adrian-dumitrescu/IoT-CAN-Battery-Monitoring/README.md

# IoT-CAN-Battery-Monitoring

Information about the device is presented in the pCloud_Documentation.pdf file.
- [x] Arduino IDE
- [x] Based on ESP8266
- [x] IoT monitoring with Thingsboard Dashboard
- [x] CAN-BUS

## License
[MIT](https://choosealicense.com/licenses/mit/)
