adrian-dumitrescu/IoT-CAN-Battery-Monitoring/pCloud_PCB/Assembly/BOM.xlsx

QTY | Parts | Description | Value | Footprint (in) | Mounting Style | Manufacturer Part Number | Manufacturer | Supplyer | Supplyer Link | Price/Unit | Price/Total | TOTAL
 | Resistors |  |  |  |  |  |  |  |  |  | 0.000 €
1 | R2 | Thick Film Resistors - SMD 1/16watt 124Kohms 1% | 124K | 0402 | SMD | CRCW0402124KFKED | Vishay / Dale | Mouser | Link1 (https://ro.mouser.com/ProductDetail/Vishay-Dale/CRCW0402124KFKED?qs=rlE3Te1NifzljNPs8nbYHA%3D%3D) | 0.090 € | 0.09 € | 49.87 €
1 | R8 | Thick Film Resistors - SMD 1/16watt 383Kohms 1% | 383K | 0402 | SMD | CRCW0402383KFKED | Vishay / Dale | Mouser | Link2 (https://ro.mouser.com/ProductDetail/Vishay-Dale/CRCW0402383KFKED?qs=iv%252Be0Bc5VY1yPDNCGroJqg%3D%3D) | 0.090 € | 0.09 €
1 | R12 | Thick Film Resistors - SMD 1/16watt 102Kohms 1% 100ppm | 102K | 0402 | SMD | CRCW0402102KFKED | Vishay / Dale | Mouser | Link3 (https://ro.mouser.com/ProductDetail/Vishay-Dale/CRCW0402102KFKED?qs=rlE3Te1NifwphdA8fQQlsA%3D%3D) | 0.090 € | 0.09 €
1 | R10 | Thick Film Resistors - SMD 1/16watt 100Kohms 1% | 100K | 0402 | SMD | CRCW0402100KFKED | Vishay / Dale | Mouser | Link4 (https://ro.mouser.com/ProductDetail/Vishay-Dale/CRCW0402100KFKED?qs=OlqPY1CiralZGKRwQ4Glcg%3D%3D) | 0.090 € | 0.09 €
2 | R13, R14 | RES SMD 1/10Watt 100ohms 1% | 100 | 0603 | SMD | CRCW0603100RFKEAC | Vishay / Dale | Mouser | Link5 (https://ro.mouser.com/ProductDetail/Vishay-Dale/CRCW0603100RFKEAC) | 0.090 € | 0.18 €
2 | R16, R17 | RES 0.25watt 10Kohms 1% 100ppm | 10K | 0603 | SMD | RCS060310K0FKEA | Vishay / Dale | Mouser | Link6 (https://ro.mouser.com/ProductDetail/Vishay-Dale/RCS060310K0FKEA) | 0.140 € | 0.28 €
8 | R5, R1, R3, R4, R7, R9, R20, R23 | Thick Film Resistors - SMD 10K OHM 1% 1/4W TC100 | 10K | 0603 | SMD | CMP0603AFX-1002ELF | Bourns | Mouser | Link7 (https://ro.mouser.com/ProductDetail/Bourns/CMP0603AFX-1002ELF?qs=TiOZkKH1s2Q14lKL9rbzLg%3D%3D) | 0.090 € | 0.72 €
1 | R25 | Thick Film Resistors - SMD 120 Ohm | 120 | 0603 | SMD | RC0603JR-7W120RL | Yageo | Mouser | Link8 (https://ro.mouser.com/ProductDetail/Yageo/RC0603JR-7W120RL) | 0.090 € | 0.09 €
1 | R21 | Thick Film Resistors - SMD 1/10Watt 22ohms 5% Commercial Use | 22 | 0603 | SMD | CRCW060322R0JNEAC | Vishay / Dale | Mouser | Link9 (https://ro.mouser.com/ProductDetail/Vishay-Dale/CRCW060322R0JNEAC?qs=E3Y5ESvWgWMu6NbfEetfrA%3D%3D) | 0.090 € | 0.09 €
2 | R11, R22 | Thin Film Resistors - SMD 1K ohm 1% 1/10W | 1 K | 0603 | SMD | RT0603FRE071KL | Yageo | Mouser | Link10 (https://ro.mouser.com/ProductDetail/Yageo/RT0603FRE071KL?qs=8cPjvKtxWv68ZVEzoi6JxQ%3D%3D) | 0.090 € | 0.18 €
2 | R15, R6 | RES 4.7Kohms 1% | 4.7K | 0603 | SMD | ERJ-3EKF4701V | Panasonic | Mouser | Link11 (https://ro.mouser.com/ProductDetail/Panasonic/ERJ-3EKF4701V) | 0.100 € | 0.20 €
1 | R26 | Thick Film Resistors - SMD 1/8Watt 470ohms 1% Commercial Use | 470 | 0805 | SMD | CRCW0805470RFKEAC | Vishay / Dale | Mouser | Link12 (https://ro.mouser.com/ProductDetail/Vishay-Dale/CRCW0805470RFKEAC?qs=E3Y5ESvWgWPsF5leBpDSrQ%3D%3D) | 0.090 € | 0.09 €
 | Capacitors |  |  |  |  |  |  |  |  |  | 0.000 €
1 | C12 | Multilayer Ceramic Capacitors MLCC - SMD/SMT 0402 6.2pF 50volts C0G +/-0.25pF | 6.2 pF | 0402 | SMD | GRM1555C1H6R2CA01D | Murata Electronics | Mouser | link13 (https://ro.mouser.com/ProductDetail/Murata-Electronics/GRM1555C1H6R2CA01D?qs=e%252BE4OD6MgMdxw4b5lMPkpQ%3D%3D) | 0.090 € | 0.09 €
1 | C15 | Multilayer Ceramic Capacitors MLCC - SMD/SMT 0.056uF 16Volts 10% | 56 nF | 0402 | SMD | GRM155R71C563KA88D | Murata Electronics | Mouser | Link14 (https://ro.mouser.com/ProductDetail/Murata-Electronics/GCM155R71C333KA37D?qs=QDXoN8f0aYKQeBiDvEx%2FuA%3D%3D) | 0.085 € | 0.09 €
8 | C16, C17, C18, C21, C22, C23, C26, C27 | Multilayer Ceramic Capacitors MLCC - SMD/SMT 100Vdc 10uF 10% 1210/2502 | 10 uF | 1210 | SMD | GRM32EC72A106KE05L | Murata Electronics | Mouser | Link15 | 1.170 € | 9.36 €
2 | C1, C10 | CAP 0.1uF 25V 20% 0603 | 0.1 uF | 0603 | SMD | CC0603ZRY5V8BB104 | Yageo | Mouser | Link16 (https://ro.mouser.com/ProductDetail/Yageo/CC0603ZRY5V8BB104) | 0.090 € | 0.18 €
4 | C13, C6, C8, C9 | CAP 10UF 25V 10% 0805 | 10 uF | 0805 | SMD | GRM21BR61E106KA73K | Murata Electronics | Mouser | Link17 (https://ro.mouser.com/ProductDetail/Murata-Electronics/GRM21BR61E106KA73K) | 0.230 € | 0.92 €
2 | C3, C4 | CAP 560pF +-5% 50V | 560 pF | 0603 | SMD | 0603N561J500CT | Walsin | Mouser | Link18 (https://ro.mouser.com/ProductDetail/Walsin/0603N561J500CT) | 0.110 € | 0.22 €
2 | C19, C20 | Multilayer Ceramic Capacitors MLCC - SMD/SMT WCAP-CSGP 22pF 0603 5% 50V MLCC | 22 pF | 0603 | SMD | 885012006053 | Wurth Elektronik | Mouser | Link19 (https://ro.mouser.com/ProductDetail/Wurth-Elektronik/885012006053?qs=0KOYDY2FL28j0s08hcyKIA%3D%3D) | 0.090 € | 0.18 €
1 | C7 | CAP 1.0uF 25V X5R 10% | 1 uF | 0603 | SMD | CC0603KRX5R8BB105 | Yageo | Mouser | Link20 (https://ro.mouser.com/ProductDetail/Yageo/CC0603KRX5R8BB105) | 0.090 € | 0.09 €
 | Other |  |  |  |  |  |  |  |  |  | 0.000 €
1 | X4 | USB Connectors 5P Quick Connect MicroUSB TypeAB Rcpt | - | - | SMD | 10104111-0001LF | Amphenol FCI | Mouser | Link21 (https://ro.mouser.com/ProductDetail/Amphenol-FCI/10104111-0001LF) | 0.600 € | 0.60 €
1 | IC2 | Supervisory Circuits 2.63V, 50ms MPU Reset Circuit | - | SOT-23-3 | SMD | APX803S05-26SA-7 or APX803S05-29SA-7 | Diodes Incorporated | Mouser | Link22 (https://ro.mouser.com/ProductDetail/Diodes-Incorporated/APX803S05-26SA-7?qs=AQlKX63v8RvXe1ZyLv0H1A%3D%3D) | 0.310 € | 0.31 €
1 | D4 | Schottky Diodes & Rectifiers 2.0A 70V | - | SMB | SMD | B270-13-F | Diodes Incorporated | Mouser | Link23 (https://ro.mouser.com/ProductDetail/Diodes-Incorporated/B270-13-F) | 0.340 € | 0.34 €
1 | Q4 | MOSFET SOT-23 N-CH LOGIC | - | SOT-23-3 | SMD | BSS138 | ON Semiconductor / Fairchild | Mouser | Link24 (https://ro.mouser.com/ProductDetail/ON-Semiconductor-Fairchild/BSS138?qs=HK%252BeIG1iaahCeqBvjB4arg%3D%3D) | 0.220 € | 0.22 €
1 | IC1 | I/O Controller Interface IC USB to UART Bridge QFN24 | - | QFN-24 | SMD | CP2104-F03-GMR | Silicon Labs | Mouser | Link25 (https://ro.mouser.com/ProductDetail/Silicon-Labs/CP2104-F03-GMR?qs=1CB38rTTsYrRJKVkczeRzA%3D%3D) | 1.400 € | 1.40 €
1 | IC3 | ESP8266 WiFi 802.11b/g/n 160Mbits | - | - | SMD | ESP-07S | RF Solutions | Mouser | Link26 (https://ro.mouser.com/ProductDetail/RF-Solutions/ESP-07S) | 8.540 € | 8.54 €
2 | S2, S5 | Tactile Switches SPST NO-G LEAD 200g | - | - | SMD | KSS221GLFS | C&K | Mouser | Link27 (https://ro.mouser.com/ProductDetail/CK/KSS221GLFS) | 0.640 € | 1.28 €
1 | D5 | Schottky Diodes & Rectifiers 1A 20V | - | SOD-123FL | SMD | MBR120VLSFT1G | ON Semiconductor | Mouser | Link28 (https://ro.mouser.com/ProductDetail/ON-Semiconductor/MBR120VLSFT1G) | 0.370 € | 0.37 €
1 | U4 | CAN Interface IC W/ SPI Interface |  | SOIC-18 | SMD | MCP2515-I/SO | Microchip Technology | Mouser | Link29 (https://ro.mouser.com/ProductDetail/Microchip-Technology/MCP2515-I-SO?qs=KwArPi4cUogGDbGnphOvtQ%3D%3D) | 1.540 € | 1.54 €
3 | Q1, Q2, Q6 | Bipolar Transistors - BJT SS SOT23 GP XSTR NPN 30V | - | SOT-23-3 | SMD | MMBT2222LT1G | ON Semiconductor | Mouser | Link30 (https://ro.mouser.com/ProductDetail/ON-Semiconductor/MMBT2222LT1G?qs=HVbQlW5zcXXDmyyswaLspw%3D%3D) | 0.110 € | 0.33 €
1 | D8 | TVS Diodes CAN BUS ESD PROTECT | - | - | SMD | PESD1CAN,215 | Nexperia | Mouser | Link31 (https://ro.mouser.com/ProductDetail/Nexperia/PESD1CAN215?qs=sGAEpiMZZMvKM5ialpXrmt7n0iEMMoO8) | 0.410 € | 0.41 €
1 | IC6 | CAN Interface IC STANDBY MODE |  | SOIC-8 | SMD | SN65HVD230DR | Texas Instruments | Mouser | Link32 (https://ro.mouser.com/ProductDetail/Texas-Instruments/SN65HVD230DR?qs=QViXGNcIEAtifeQR3pYVUQ%3D%3D) | 1.850 € | 1.85 €
1 | U2 | LDO Voltage Regulators 500mA | - | SOT-23-5 | SMD | SPX3819M5-L-3-3/TR | MaxLinear | Mouser | Link33 (https://ro.mouser.com/ProductDetail/MaxLinear/SPX3819M5-L-3-3-TR) | 0.630 € | 0.63 €
1 | S1 | Slide Switches slide switch with location lug | - | - | SMD | SSAJ110100 | Alps Alpine | Mouser | Link34 (https://ro.mouser.com/ProductDetail/Alps-Alpine/SSAJ110100) | 1.510 € | 1.51 €
1 | LED4 | SK6812 LEDs | - | 5050 | SMD | 2760 | Adafruit | Mouser | Link35 (https://ro.mouser.com/ProductDetail/Adafruit/2760?qs=F12%252BZJI6bgoI7KDe7TbBLw%3D%3D) | 0.504 € | 0.50 €
1 | D1 | DIODE-SCHOTTKYSOD-123 | - | SOD-123FL | SMD | MBR120ESFT3G | ON Semiconductor | Mouser | Link36 (https://ro.mouser.com/ProductDetail/ON-Semiconductor/MBR120ESFT3G) | 0.320 € | 0.32 €
1 | L1 | CLF6045T-151M-D | 150uH | - | SMD | CLF6045T-151M-D or CLF6045T-101M-D | TDK | Mouser | Link38 (https://ro.mouser.com/ProductDetail/TDK/CLF6045T-151M-D) | 1.120 € | 1.12 €
1 | IC4 | Switching Voltage Regulators | - | VSON-10 | SMD | LM5166DRCR | Texas Instruments | Mouser | Link39 (https://ro.mouser.com/ProductDetail/Texas-Instruments/LM5166DRCR?qs=34RfhUjJmKfBnYp2E2XqEQ%3D%3D) | 2.870 € | 2.87 €
1 | Q3 | Crystal SMD 16MHz | 16Mhz | - | SMD | COM-00094 | SparkFun | Mouser | Link40 (https://ro.mouser.com/ProductDetail/SparkFun/COM-00094) | 1.350 € | 1.35 €
EXTERNAL COMPONENTS (NOT TO BE MOUNTED / BOUGHT):
QTY | Parts | Description | Value | Footprint (in) | Mounting Style | Manufacturer Part Number | Manufacturer | Supplyer | Supplyer Link | Price/Unit | Price/Total | TOTAL
1 | DISP1 | 1.14 inch IPS HD TFT LCD display with 135x240 dots | - | - | SMD | ER-TFT1.14-1 | EastRising | buydisplay | Link41 (https://www.buydisplay.com/1-14-inch-tft-lcd-display-ips-panel-screen-135x240-for-smart-watch) | 2.60 € | 2.60 €
1 | CON | USB Connectors MICRO B PLUG ASBY VERT PCB | - | - | TH | ZX20-B-5S-UNIT(30) | Hirose Connector | Mouser | Link42 (https://ro.mouser.com/ProductDetail/Hirose-Connector/ZX20-B-5S-UNIT30) | 0.74 € | 0.74 €
1 | CON-Metal | USB Connectors MICRO B PLUG SHIELD FOR ZX20 VERT TH | - | - | TH | ZX20-B-SLDC | Hirose Connector | Mouser | Link43 (https://ro.mouser.com/ProductDetail/Hirose-Connector/ZX20-B-SLDC) | 0.22 € | 0.22 €
1 | Antenna | 2.4G 5.8G dual band FPC Antenna 31*5.5 cm | - | - | Snap In |  | - | Alibaba |  | 0.40 € | 0.40 €
1 | Panel CON | USB Connectors RUGGED MICRO AB VERTICAL | - | - | Panel | MUSBK55230 | Amphenol Commercial Products | Mouser | Link44 (https://ro.mouser.com/ProductDetail/Amphenol-Commercial-Products/MUSBK55230?qs=z4I1WACWgPQfLC8Dgw9I8w%3D%3D) | 7.1 | 7.10 €
