adrian-dumitrescu/IoT-CAN-Battery-Monitoring/pCloud_PCB/Assembly/3D_Render/pCloud_ESP926_BOT.png

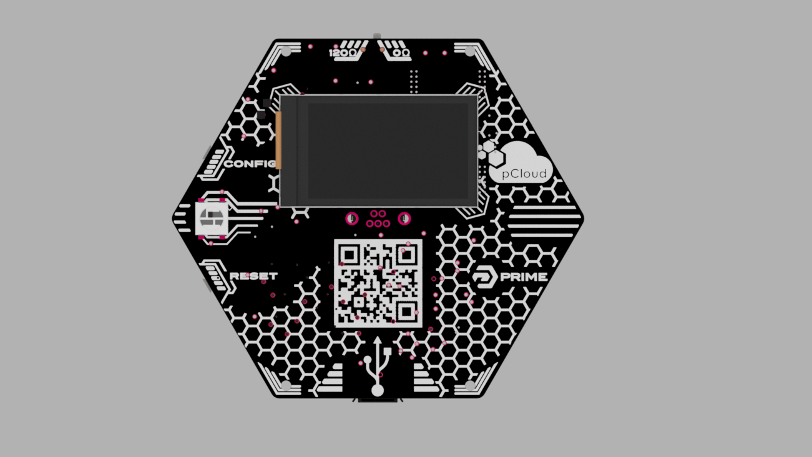
pCloud_PCB/Assembly/3D_Render/pCloud_ESP926_BOT.png
