adrian-dumitrescu/IoT-CAN-Battery-Monitoring/pCloud_Documentation.pdf

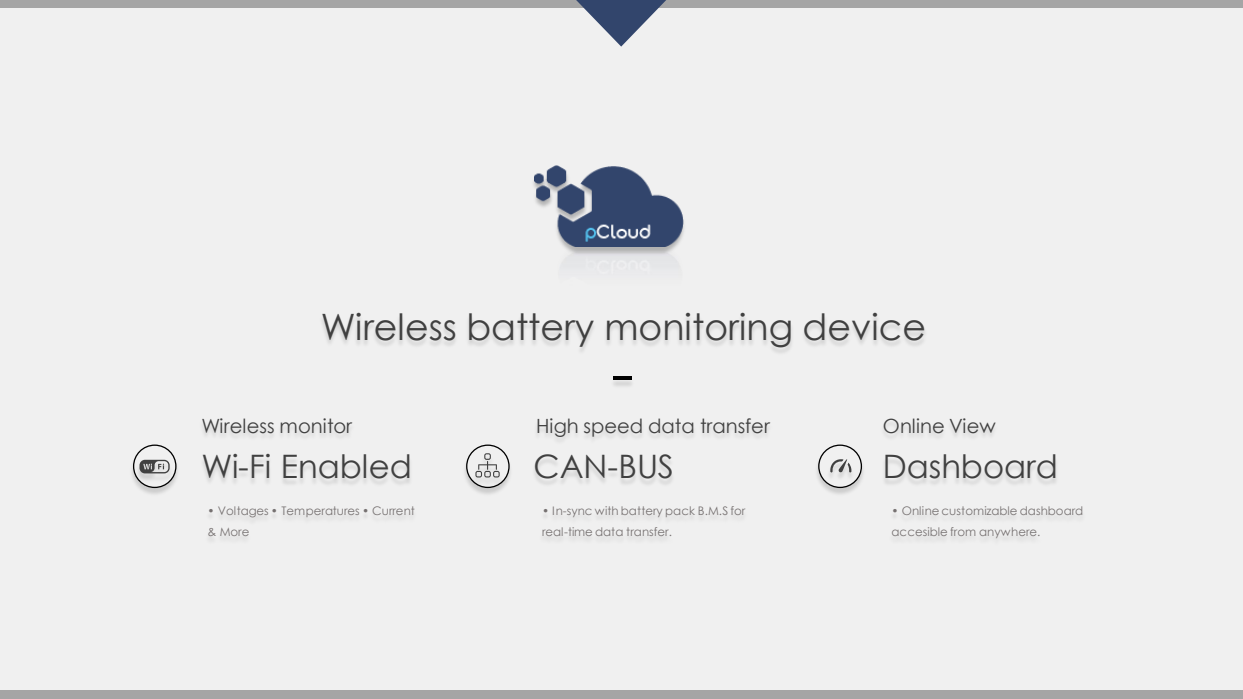
[picture p5: page 1]
Online View Dashboard

Wireless battery monitoring device

Wireless monitor
Wi-Fi Enabled

High speed data transfer
CAN-BUS

• Voltages • Temperatures • Current
& More

• In-sync with battery pack B.M.S for
real-time data transfer.

• Online customizable dashboard

accesible from anywhere.

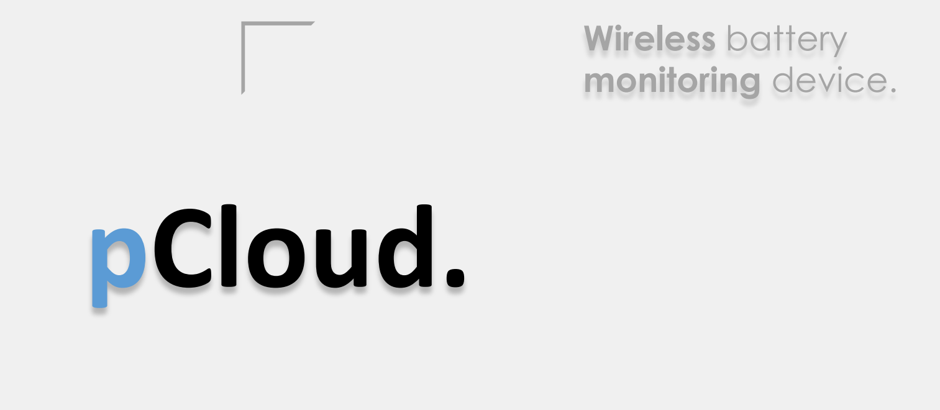
[picture p6: figure]
pCloud.; Wireless battery monitoring device.

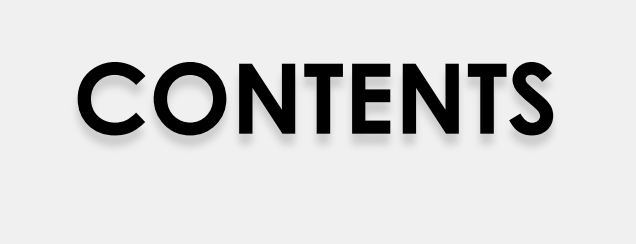
[picture p7: figure]
CONTENTS

# 03 Design

# 04 Dashboard

## 01 Brief introduction into what pCloud is and what it wants to

## 03 Sneak peek of the pCloud. Preview our out of the box solution

## 04 Online dashboard that provides 24/7 instant data, charts of

recent history, and diagnostic information.

# 02 Architecture

## 02 The data transportation architecture is designed to distribute

workload across multiple nodes without a single point of failure.

01. INTRODUCTION.

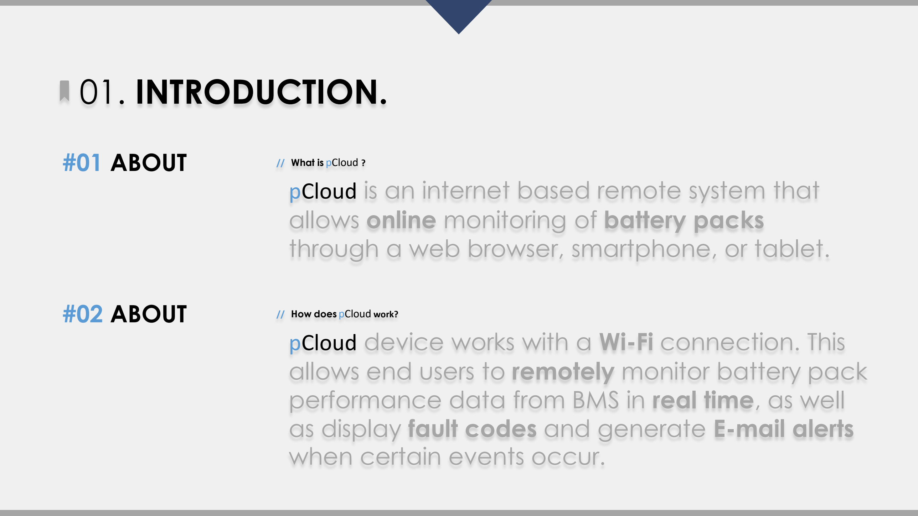
[picture p8: page 4]

# pCloud is an internet based remote system that allows online monitoring of battery packs

through a web browser, smartphone, or tablet.

#01 ABOUT | // What is pCloud ?

# pCloud device works with a Wi-Fi connection. This allows end users to remotely monitor battery pack performance data from BMS in real time, as well as display fault codes and generate E-mail alerts

when certain events occur.

#02 ABOUT | // How does pCloud work?

02. ARCHITECTURE.

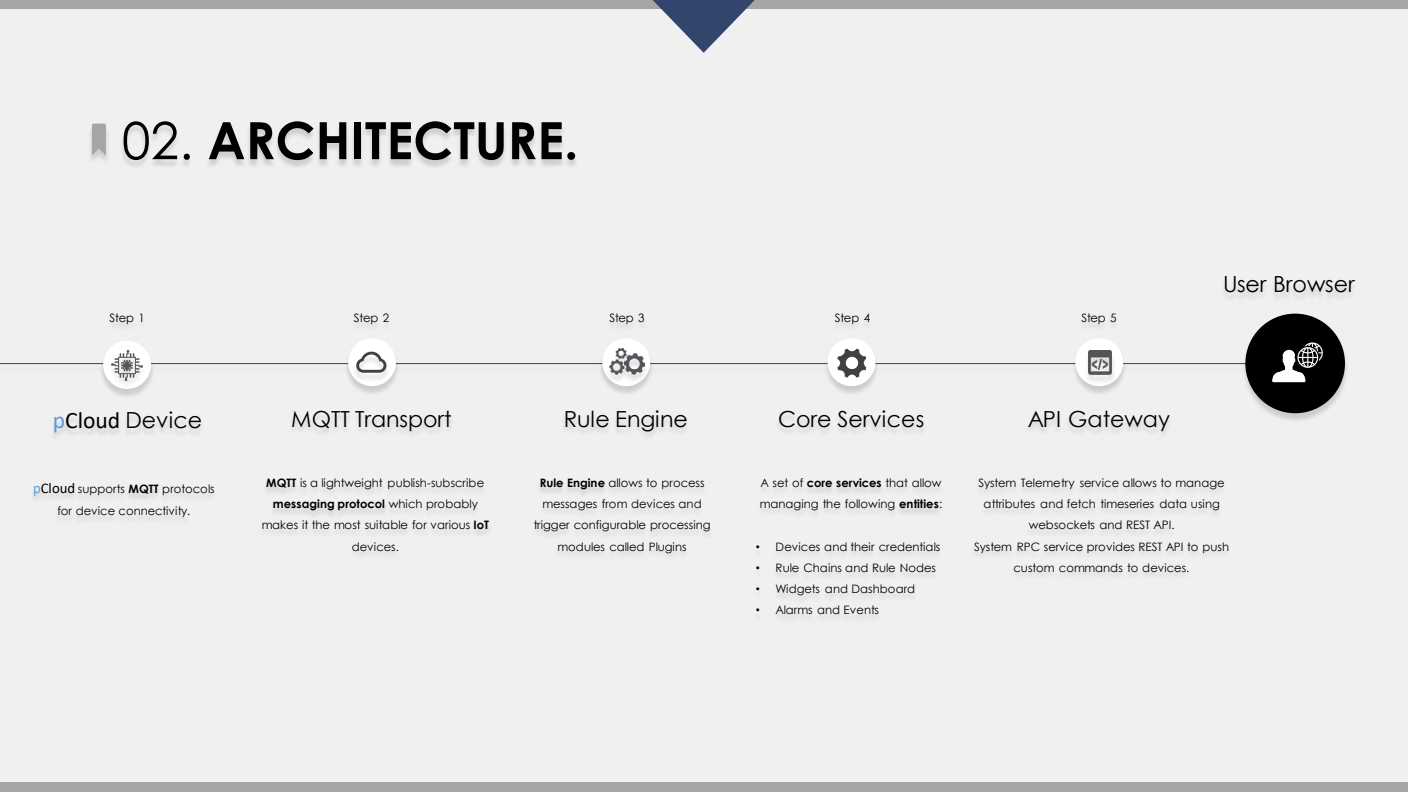
[picture p9: page 5]
pCloud Device; MQTT Transport; devices.; Rule Engine; Core Services; User Browser; API Gateway; Step 1; Step 2; Step 3; Step 4; Step 5

pCloud supports MQTT protocols

MQTT is a lightweight publish-subscribe

Rule Engine allows to process

A set of core services that allow

System Telemetry service allows to manage

for device connectivity.

messaging protocol which probably

messages from devices and

managing the following entities:

attributes and fetch timeseries data using

makes it the most suitable for various IoT

trigger configurable processing

websockets and REST API.

modules called Plugins

• Devices and their credentials

System RPC service provides REST API to push

• Rule Chains and Rule Nodes

custom commands to devices.

• Widgets and Dashboard

• Alarms and Events

Wi

## -Fi Enabled

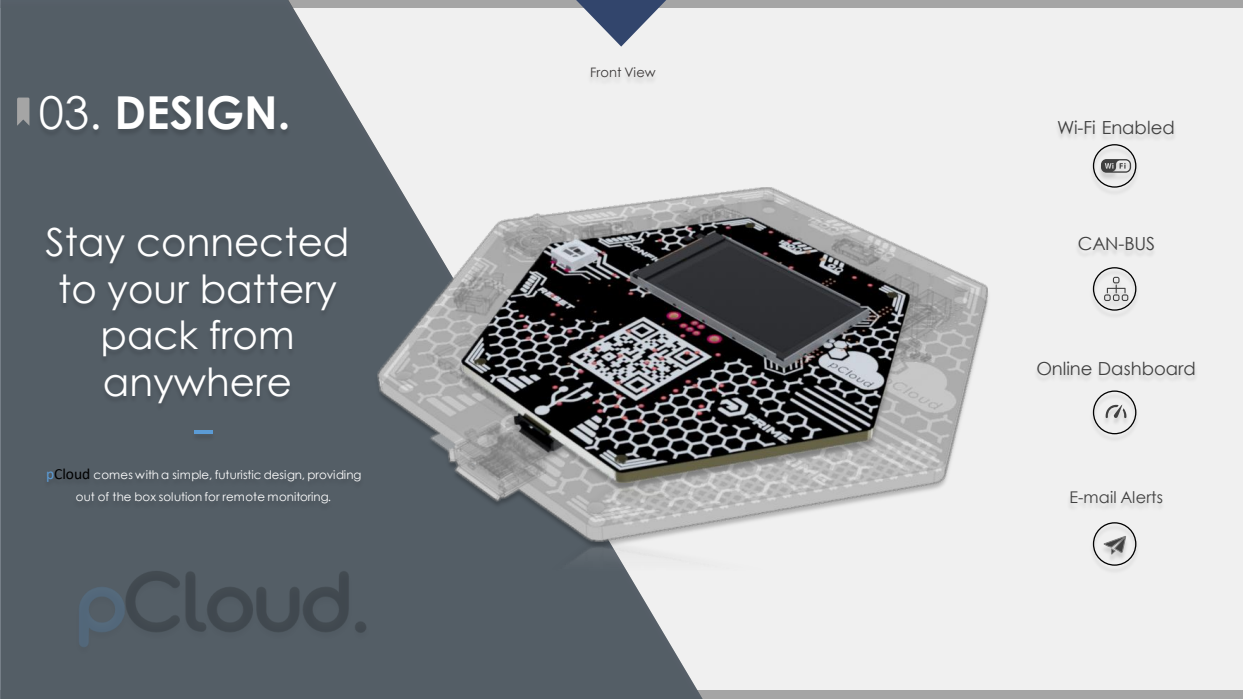
[picture p10: page 6]
CAN; -BUS; Online Dashboard; -mail Alerts; 3. DESIGN; Front View

Stay connected
to your battery
pack from
anywhere

pCloud comes with a simple, futuristic design, providing

out of the box solution for remote monitoring

# Wide viewing angle Display

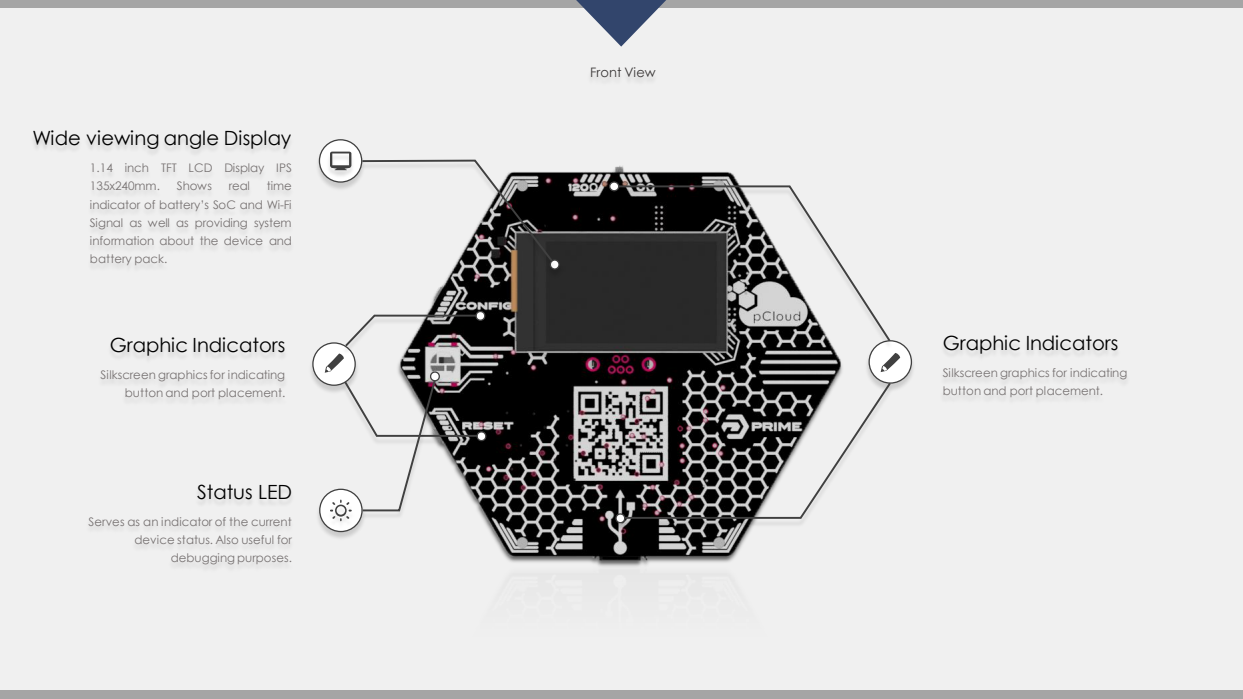
[picture p11: page 7]
debugging purposes.; Status LED; Shows; real; time; Graphic Indicators; Front View

1.14 inch TFT LCD Display IPS
indicator of battery’s SoC and Wi-Fi
Signal as well as providing system
information about the device and
battery pack.

Silkscreen graphics for indicating
button and port placement.

Serves as an indicator of the current

device status. Also useful for

## ESP8266

## μController

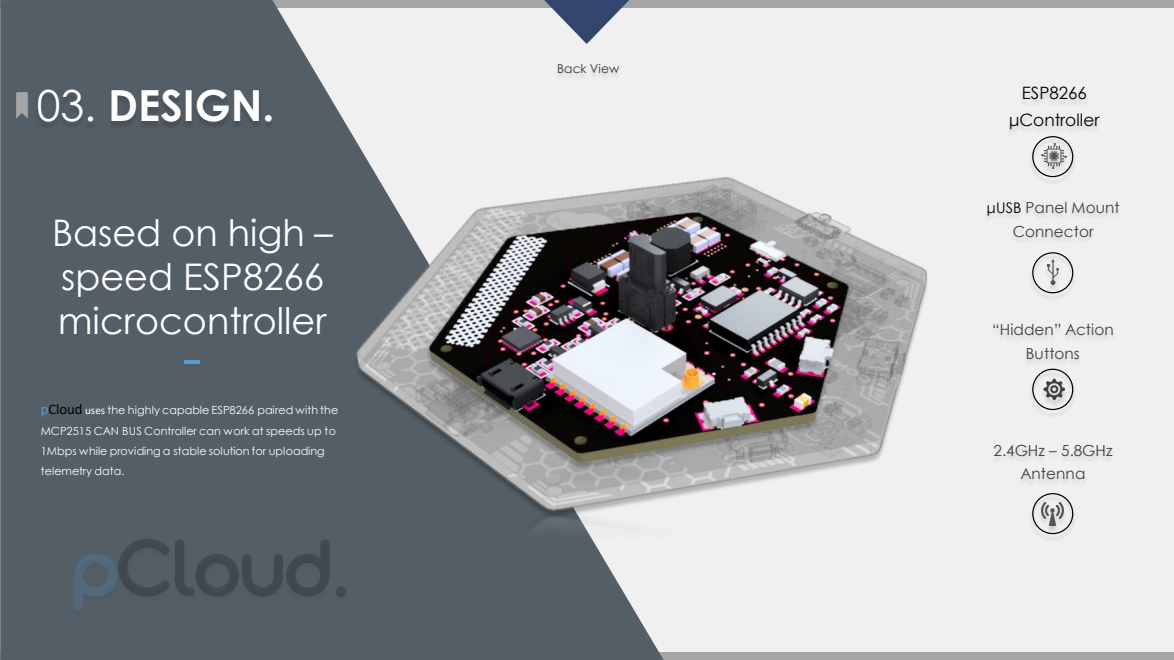
[picture p12: page 8]
telemetry data; “Hidden” Action; Buttons; 2.4GHz; – 5.8GHz; Antenna; Back View; 3. DESIGN

μUSB Panel Mount
Connector

Based on high
speed ESP8266
microcontroller

pCloud usesthe highly capable ESP8266 paired with the

MCP2515 CAN BUS Controller can work at speeds up to
1Mbps while providing a stable solution for uploading

# CAN-BUS Resistor Switch

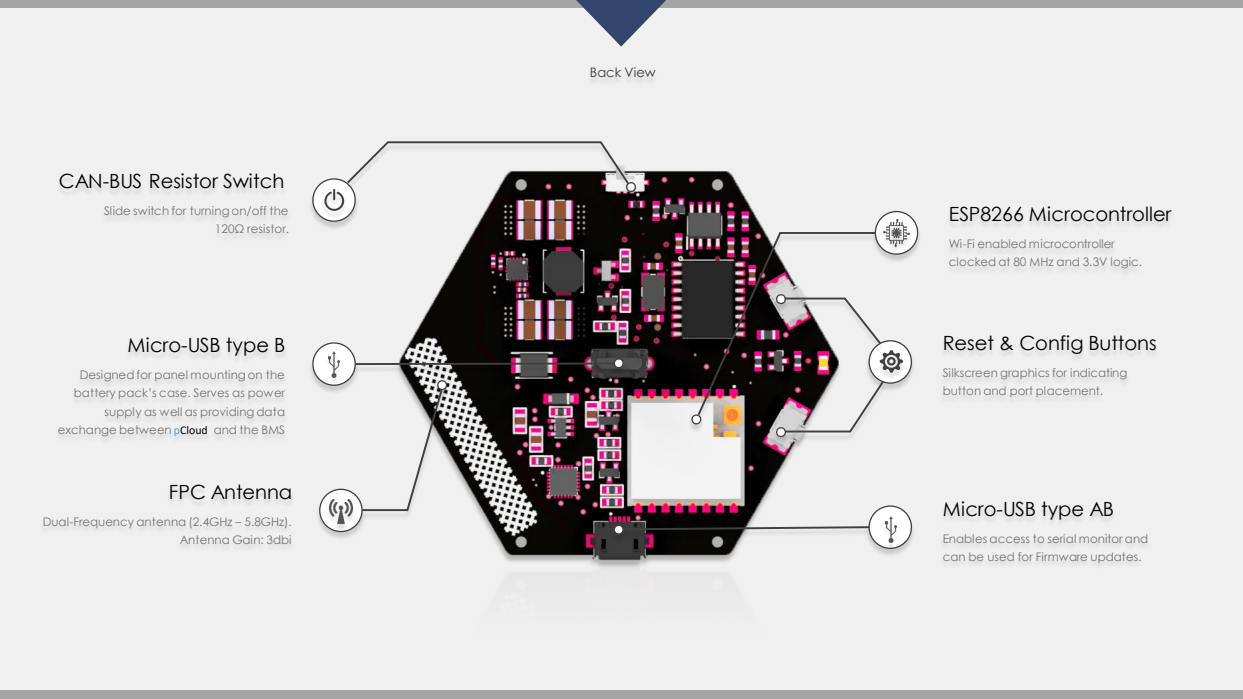
[picture p13: page 9]
Antenna Gain: 3dbi; FPC Antenna; 120Ω resistor.; Back View

ESP8266 Microcontroller Slide switch for turning on/off the

Wi-Fi enabled microcontroller
clocked at 80 MHz and 3.3V logic.

Reset & Config Buttons

Micro-USB type B

Designed for panel mounting on the
battery pack’s case. Serves as power
supply as well as providing data

Silkscreen graphics for indicating
button and port placement.

exchange between pCloud and the BMS

Micro-USB type AB

Dual-Frequency antenna (2.4GHz – 5.8GHz).

Enables access to serial monitor and
can be used for Firmware updates.

# Wide Angle Display Slide Switch

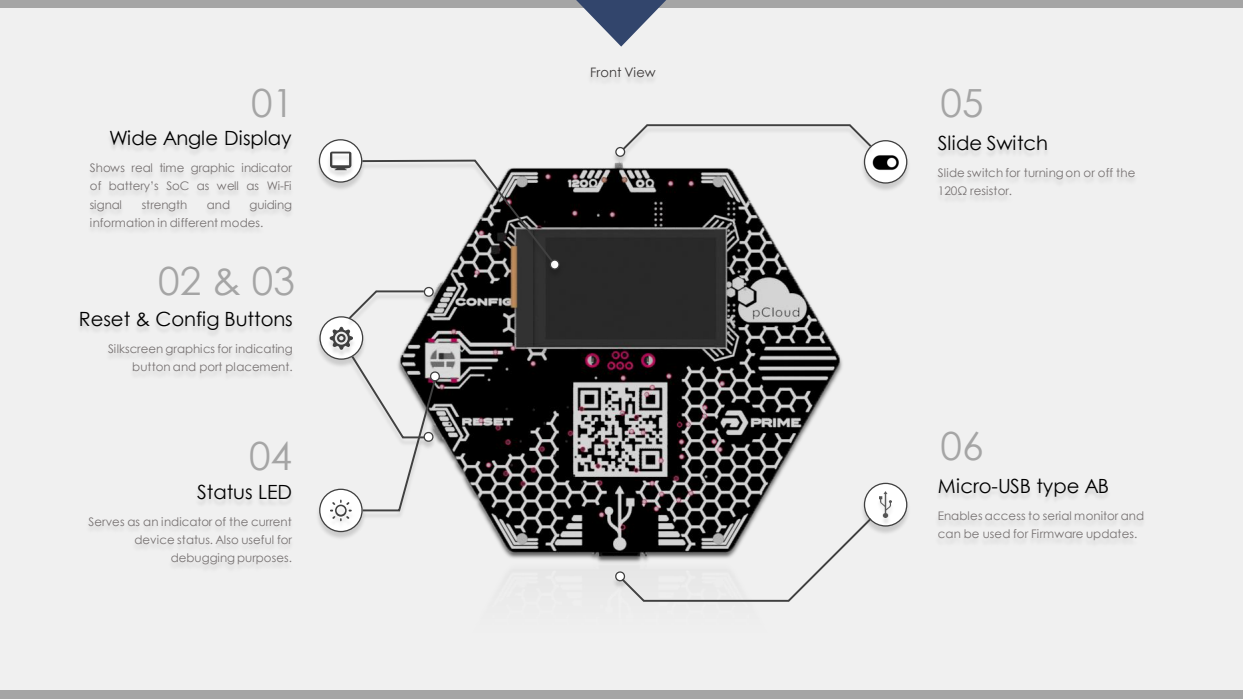
[picture p14: page 10]
debugging purposes.; Status LED; signal; strength; and; guiding; Front View; Micro

Shows real time graphic indicator
of battery’s SoC as well as Wi
information in different modes

Slide switch for turning on or off the
120Ω resistor.

Reset & Config Buttons

Silkscreen graphics for indicating
button and port placement.

-USB type AB

Enables access to serial monitor and
can be used for Firmware updates.

Serves as an indicator of the current

device status. Also useful for

01

## Signal Strength

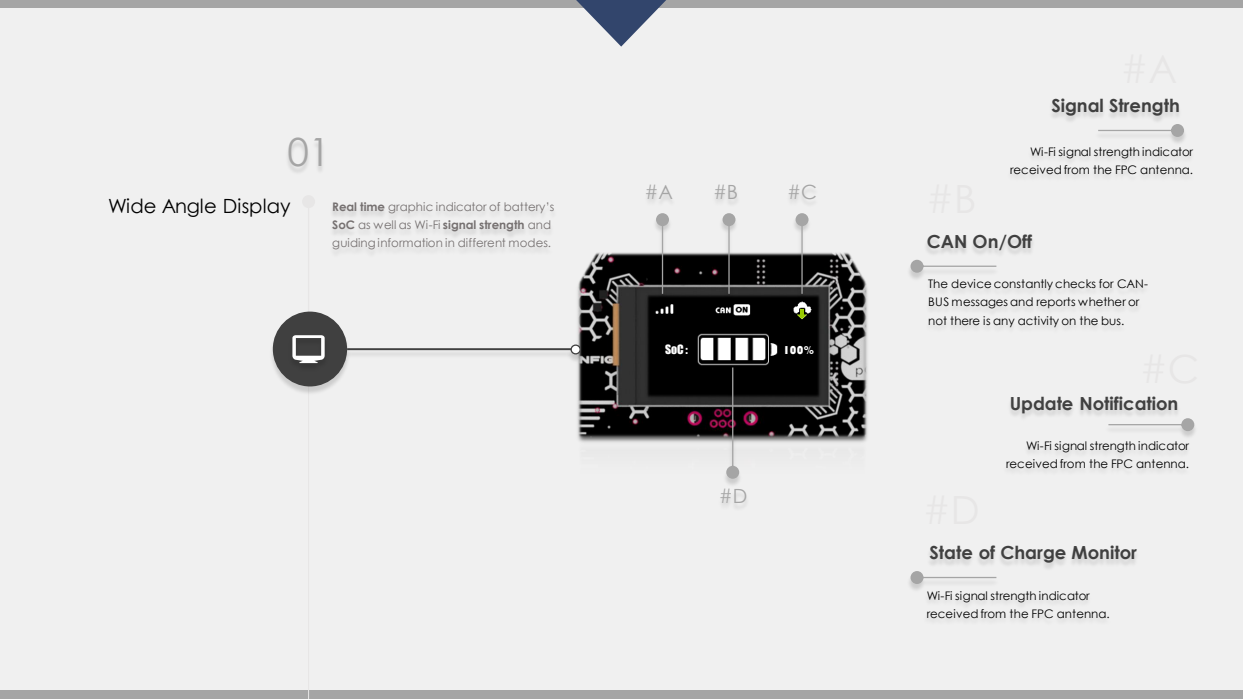
[picture p15: page 11]
SoC :; Update Notification

Wi-Fi signal strength indicator
received from the FPC antenna.

Wide Angle Display

Real time graphic indicator of battery’s
SoC as well as Wi-Fi signal strength and
guiding information in different modes.

CAN On/Off

The device constantly checks for CAN-
BUS messages and reports whether or
not there is any activity on the bus.

State of Charge Monitor

Provides two distinct functionalities:
#A. Config Portal – Hold for 5 seconds to go into Config Mode #B. Firmware Update – Double tap on the side button to perform a firmware update if there is one available.

Single press on the reset button will give a quick reset to the device.

# Reset Side Button

02

03

# Config Side Button

- Once you enter Config Mode, the device will become an Access Point.
- Connect to the Access Point using either your mobile device or PC and you will be redirected to a private Web Page.
- If you are not redirected after a few seconds, open a browser and type in the following IP: http://192.168.4.1/
- On the Web Page you will be able to insert:
- SSID : The name of the Wi-Fi that is within range of the device. This will provide internet connection to upload telemetry data.
- Password : Wi-Fi network security key.
- Server IP : Provided with the device.
- Private Token : provided with the device. Please do not share with anyone your private token.
- After inserting all information click on SAVE and wait a few seconds for your device to finish the configuration.
- The Web Page also provides useful information about the device and a help menu.

## Config Portal

#A

- Performs over the air Firmware Update if there is a new version available

## Firmware Update

#B

Serves as an indicator of the current device status. The LED will display certain colors depending on it’s current state:

#A. Constant RED

#B. Constant GREEN

#C. Color Cycle.

# 04 Status LED

## Constant RED

#A

The RED color indicates that the device lost connectivity and is trying to reconnect to the Wi-Fi. If this problem persists the signal strength might not be strong enough to maintain good connection.

The device is into Config Mode and is waiting for you to finish the configuration process.

## Constant GREEN

#B

## Color Cycle

#C

While the device is monitoring the Battery Pack, it the LED will smoothly cycle through all colors.

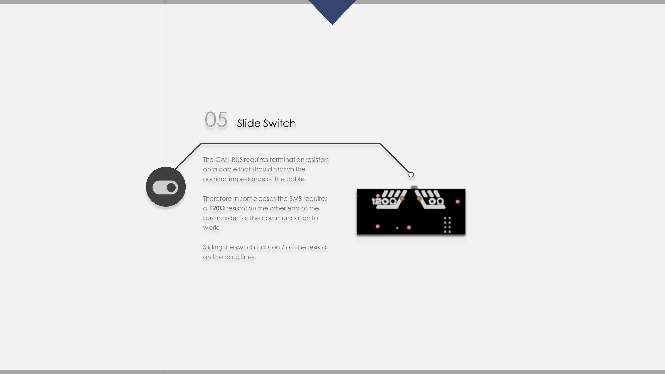
[picture p16: figure]
The CAN-BUS requires termination resistors; on a cable that should match the; nominal impedance of the cable.; a 120Ω resistor on the other end of the; bus in order for the communication to; work.; on the data lines.; 05 Slide Switch

Therefore in some cases the BMS requires

Sliding the switch turns on / off the resistor

## Micro-USB type B Female

#A

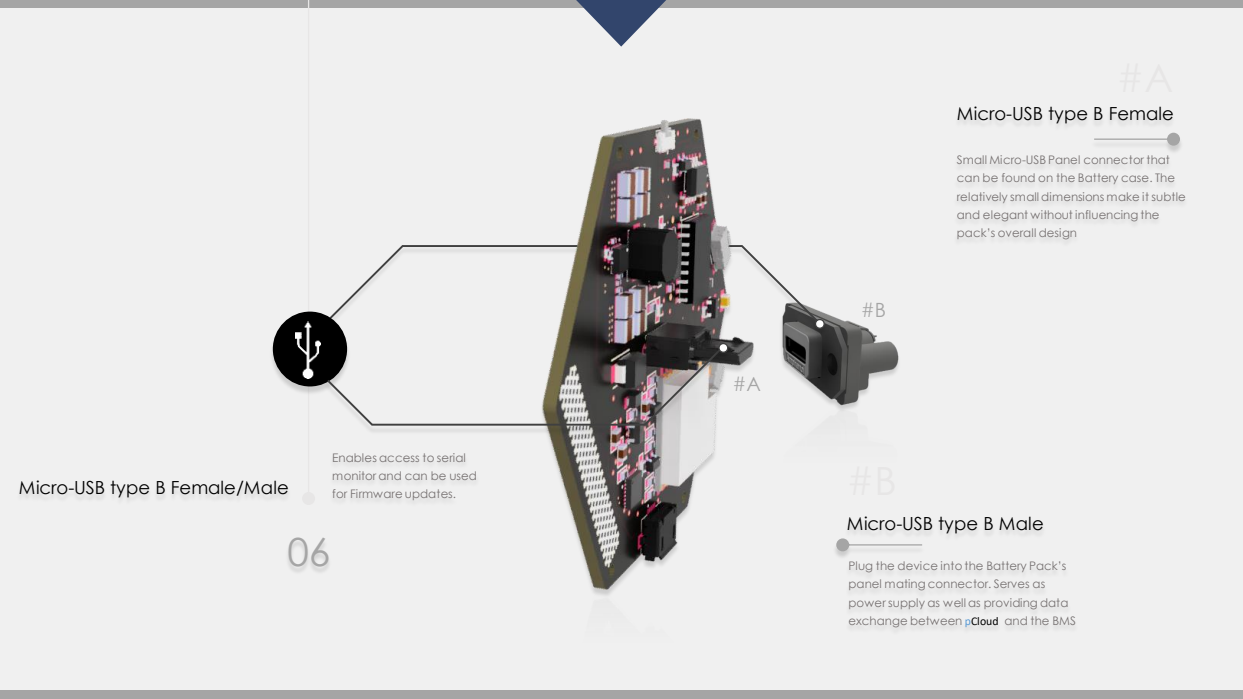
[picture p17: page 15]
Micro; for Firmware updates. -USB type B Female/Male

Small Micro-USB Panel connector that
can be found on the Battery case. The
relatively small dimensions make it subtle
and elegant without influencing the
pack’s overall design

Enables access to serial
monitor and can be used

Micro-USB type B Male

Plug the device into the Battery Pack’s
panel mating connector. Serves as
power supply as well as providing data
exchange between pCloud and the BMS

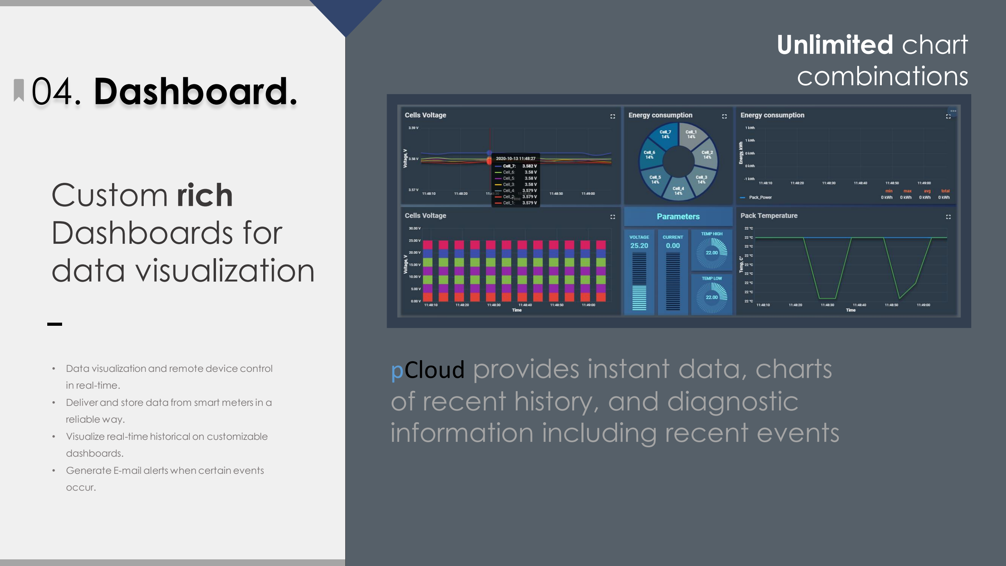
[picture p18: figure]
Custom rich Dashboards for data visualization; in real-time.; reliable way.; dashboards.; occur.; Unlimited chart combinations 04. Dashboard.; pCloud provides instant data, charts of recent history, and diagnostic information including recent events

- Data visualization and remote device control
- Deliver and store data from smart meters in a
- Visualize real-time historical on customizable
- Generate E-mail alerts when certain events
