adrian-dumitrescu/IoT-CAN-Battery-Monitoring/pCloud_PCB/Assembly/Drawings/pCloud_ESP9266_Assembly_BOT_MIRROR.pdf

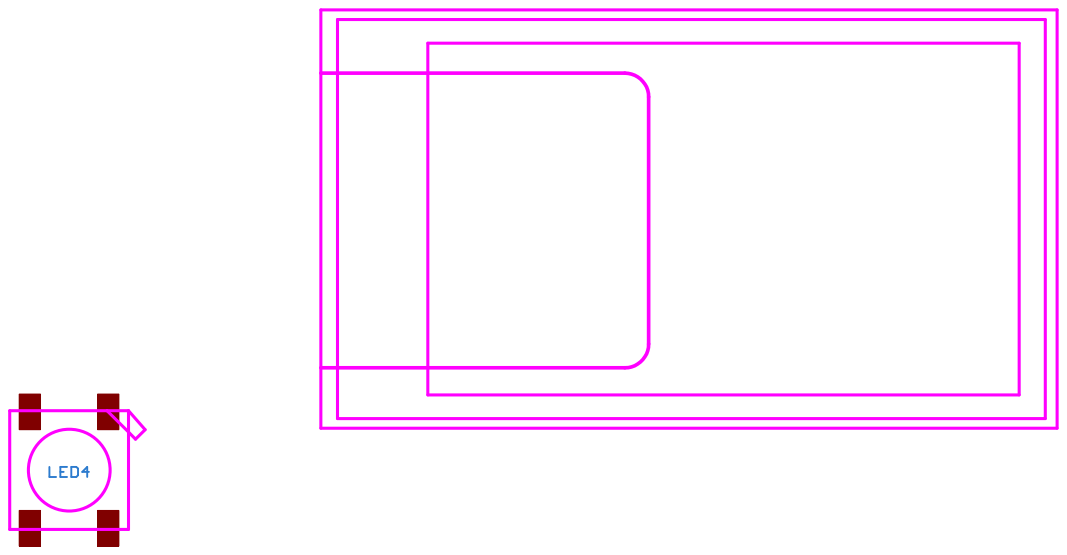
[picture p19: page 1]
