adrian-dumitrescu/IoT-CAN-Battery-Monitoring/pCloud_PCB/Assembly/Drawings/pCloud_ESP9266_Assembly_TOP.pdf

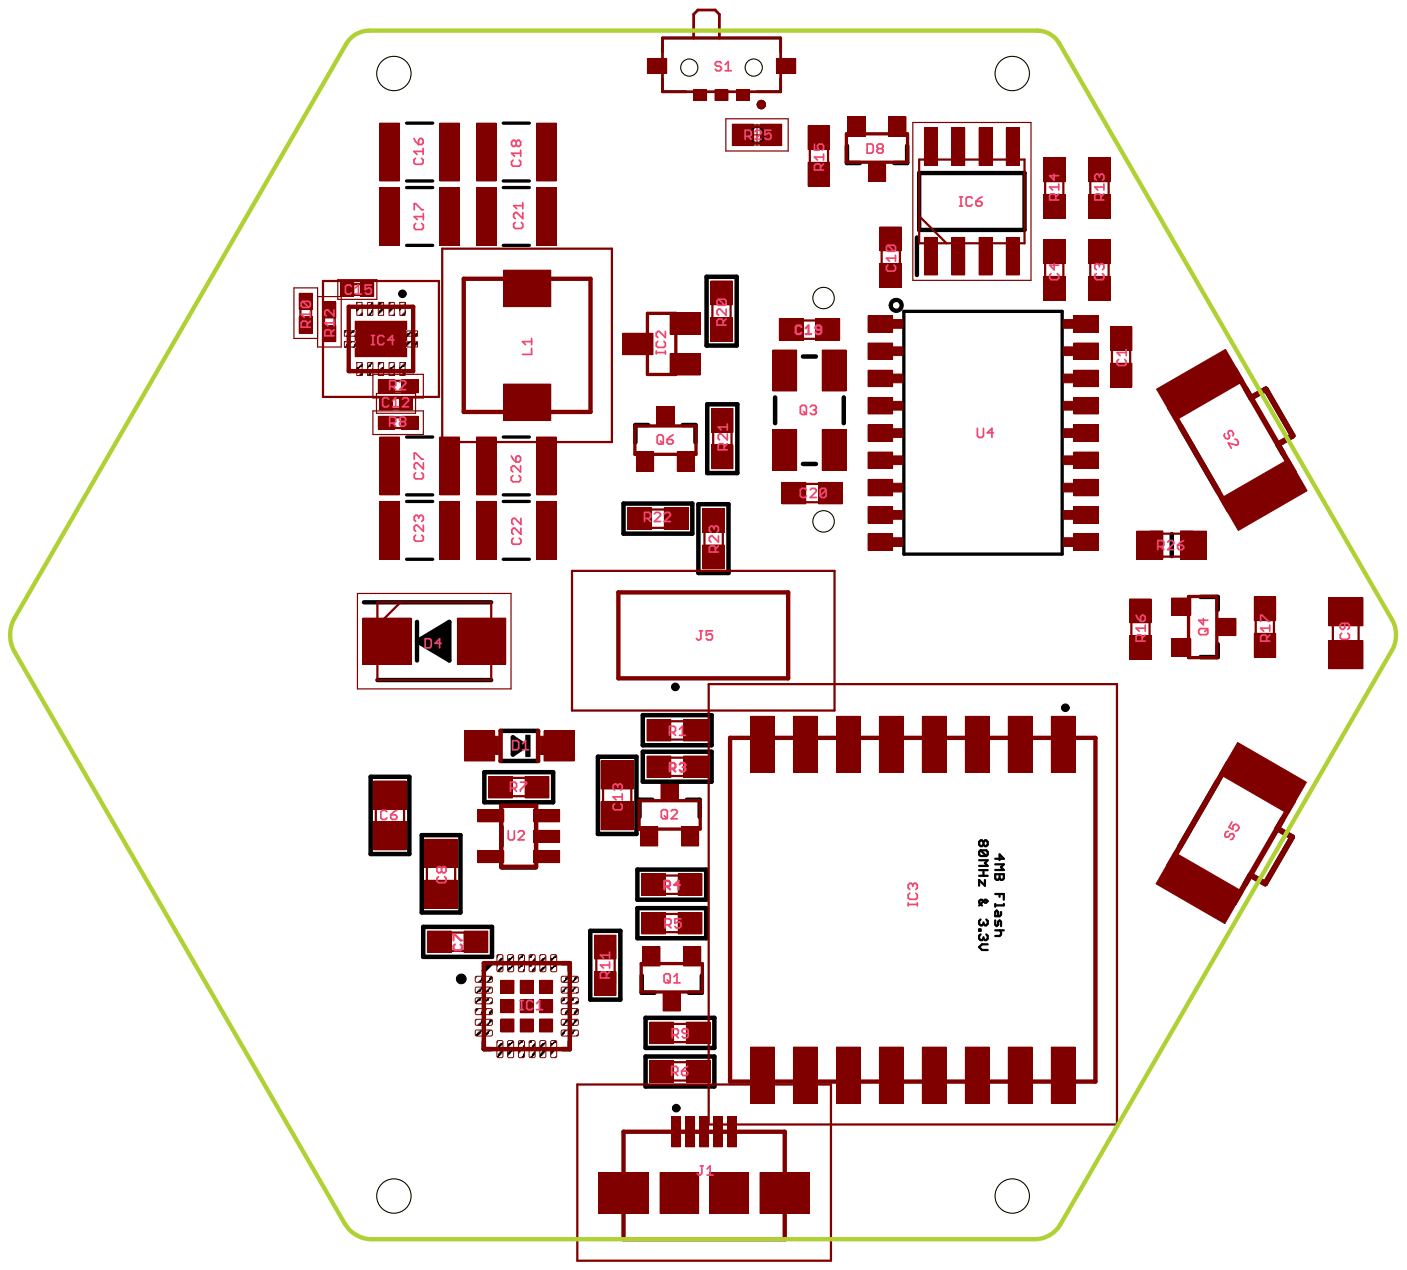
[picture p20: page 1]
