adrian-dumitrescu/IoT-CAN-Battery-Monitoring/pCloud_PCB/Schematic/pCloud_ESP9266.brd

## EAGLE design pCloud_PCB/Schematic/pCloud_ESP9266.brd (2022-10-04)

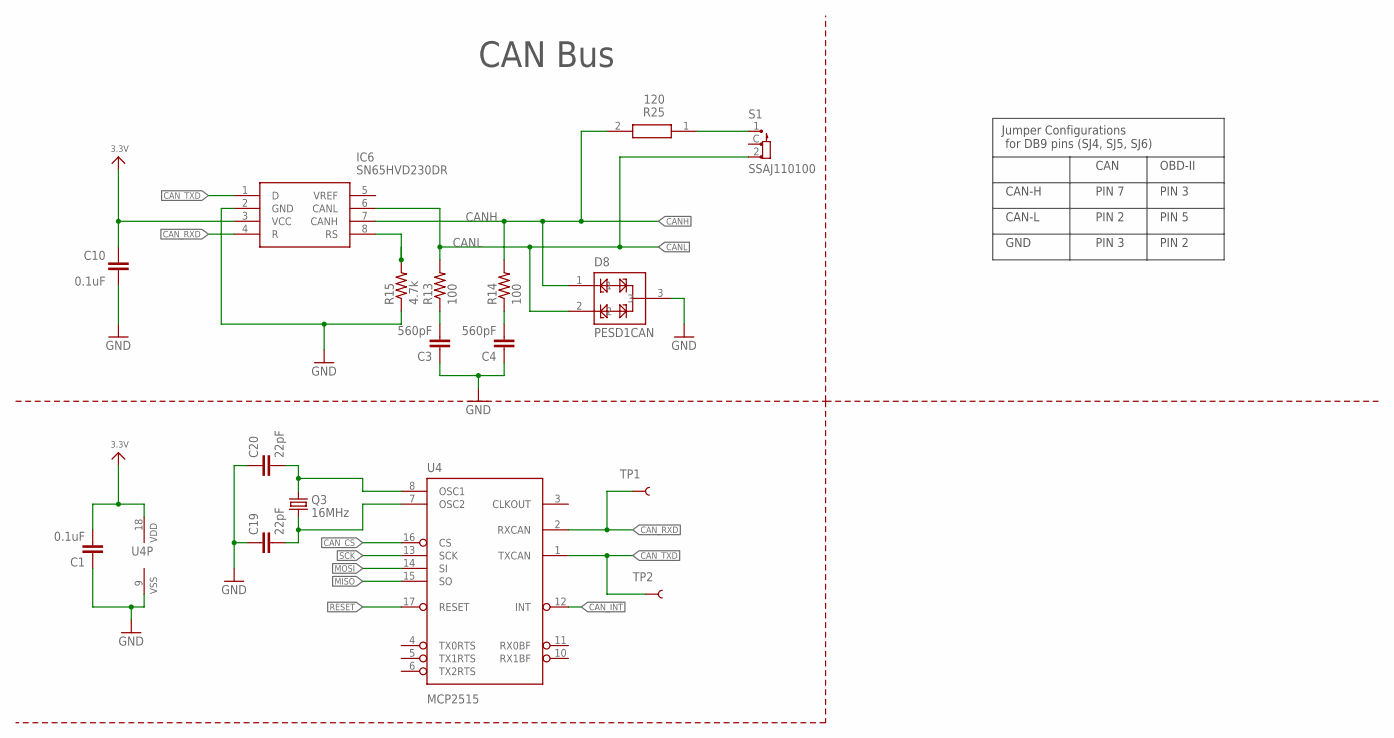
[picture p21: schematic pCloud_ESP9266.sch, sheet 1, CAN 1]

Parts:
C1, C10: 0.1uF; 0603
C3, C4: 560pF; 0603
C19, C20: 22pF; 0603
D8: PESD1CAN; SOT23-3
IC6: SN65HVD230DR; SOT127P600X175-8N
Q3: 16MHz; CRYSTAL-SMD-5X3
R13, R14: 100; 0603
R15: 4.7k; 0603
R25: 120; RESC1608X55N
S1: SSAJ110100; SW_SSAJ110100
TP1, TP2: TEST-POINT3X5; PAD.03X.05
U4: MCP2515; SO-18W

Connections:
3.3V: C1.2, C10.2, IC6.3 (VCC), U4.18 (VDD); also elsewhere on the board
CANH: D8.1, IC6.7 (CANH), R14.2, R25.2; also elsewhere on the board
CANL: D8.2, IC6.6 (CANL), R13.2, S1.2; also elsewhere on the board
CAN_CS: U4.16 (CS); also elsewhere on the board
CAN_INT: U4.12 (INT); also elsewhere on the board
CAN_RXD: IC6.4 (R), TP1.P$1, U4.2 (RXCAN)
CAN_TXD: IC6.1 (D), TP2.P$1, U4.1 (TXCAN)
GND: C1.1, C3.1, C4.1, C10.1, C19.1, C20.1, D8.3, IC6.2 (GND), R15.1, U4.9 (VSS); also elsewhere on the board
MISO: U4.15 (SO); also elsewhere on the board
MOSI: U4.14 (SI); also elsewhere on the board
unnamed: C3.2, R13.1
unnamed: C4.2, R14.1
unnamed: R25.1, S1.1
unnamed: IC6.8 (RS), R15.2
unnamed: C20.2, Q3.3 (2), U4.8 (OSC1)
unnamed: C19.2, Q3.1, U4.7 (OSC2)
RESET: U4.17 (RESET); also elsewhere on the board
SCK: U4.13 (SCK); also elsewhere on the board

Notes on the sheet:
CAN Bus
CAN
OBD-II
CAN-H
CAN-L
GND
PIN 5
PIN 2
PIN 3
PIN 7
Jumper Configurations for DB9 pins (SJ4, SJ5, SJ6)

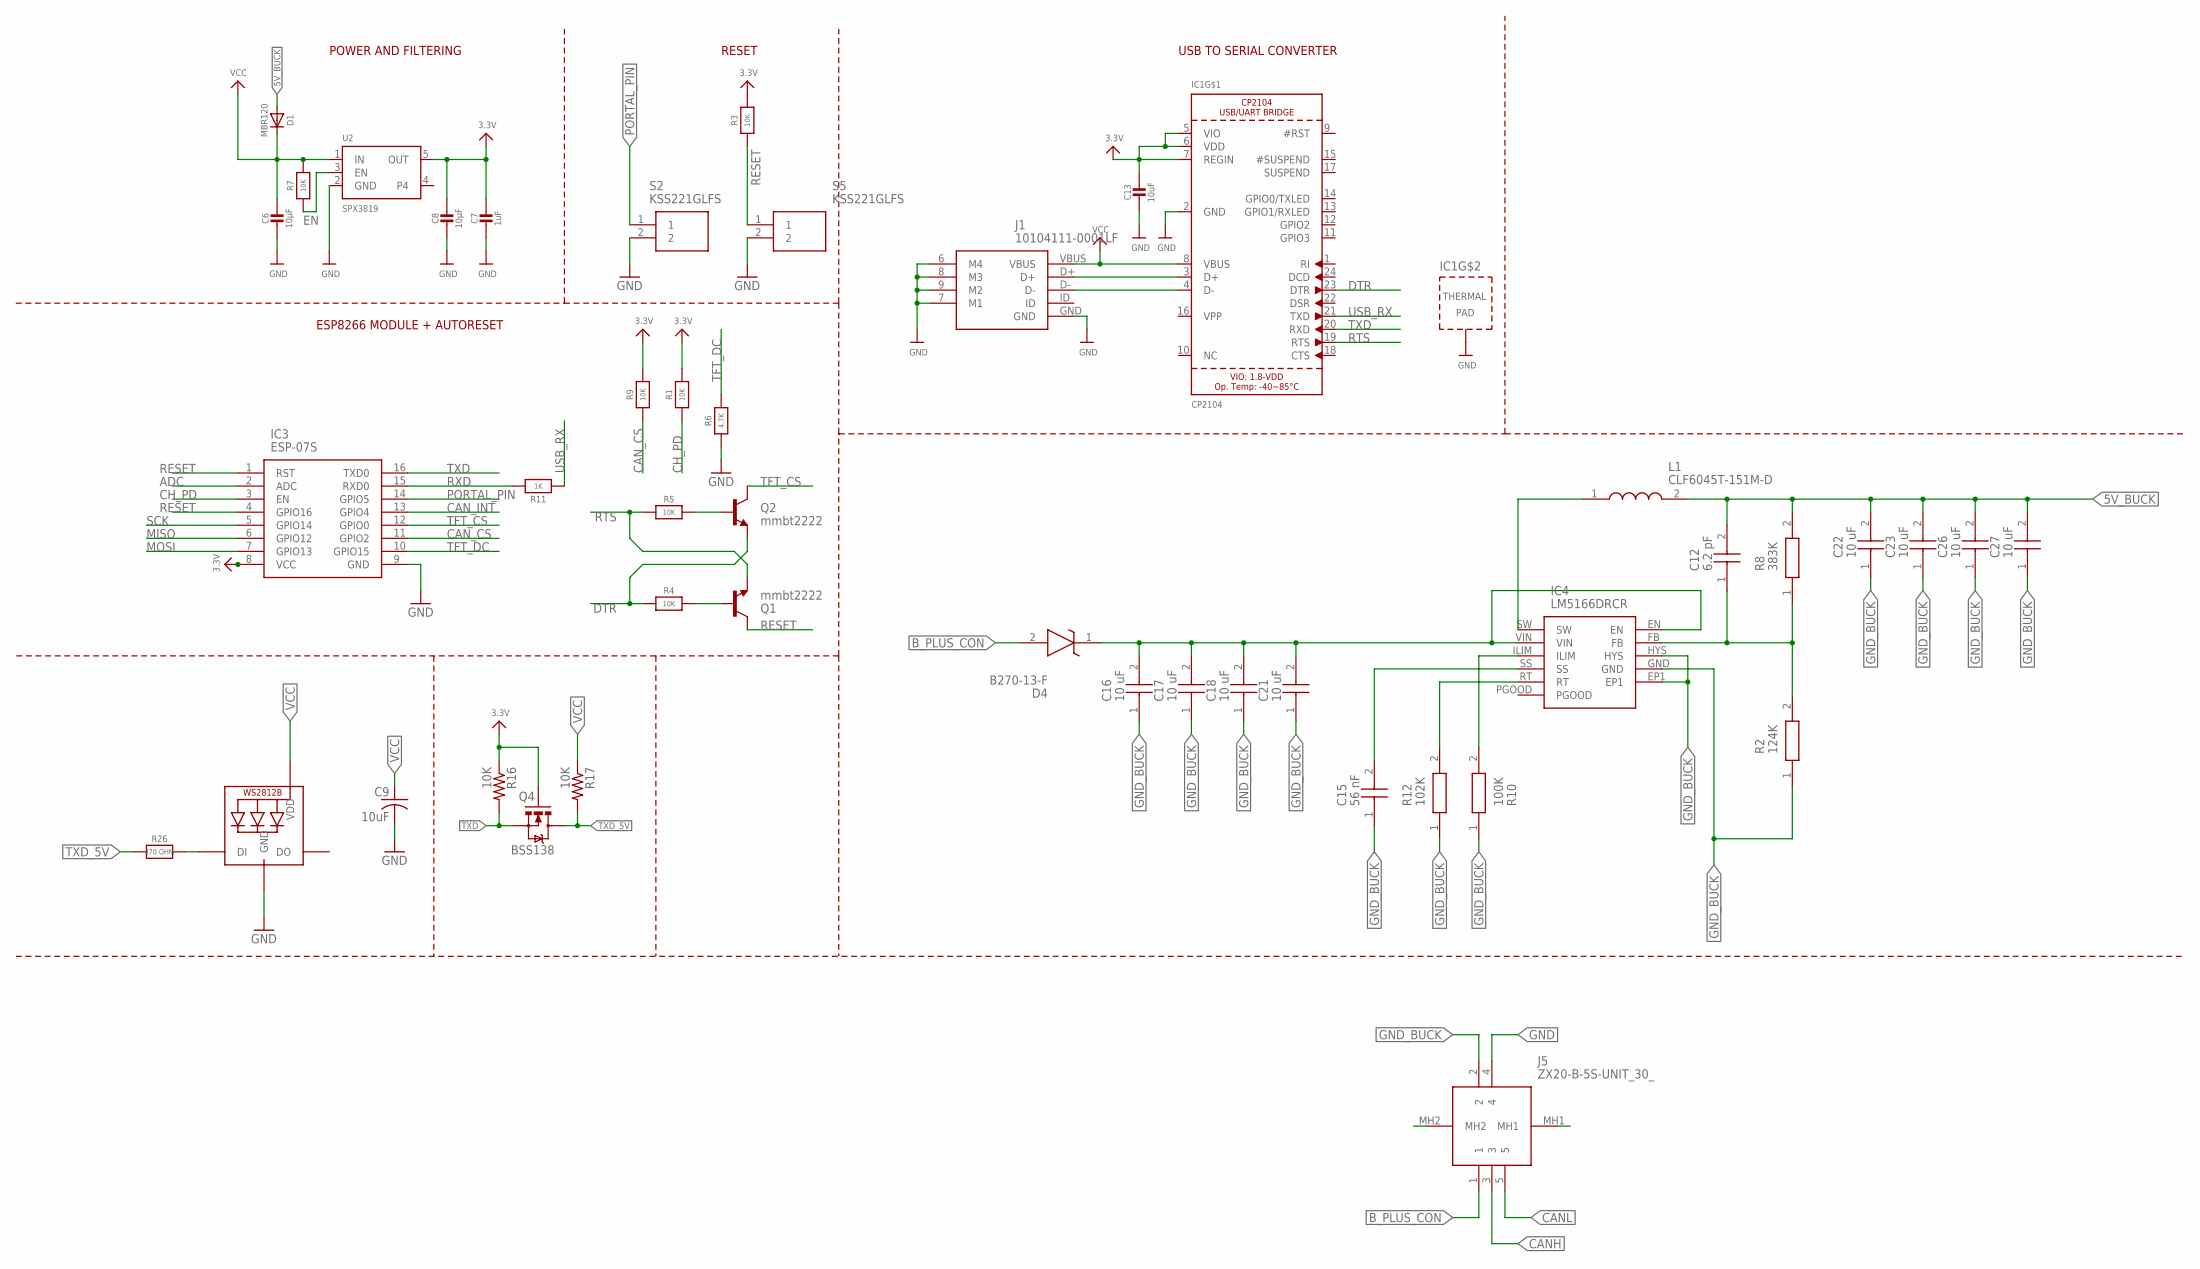
[picture p22: schematic pCloud_ESP9266.sch, sheet 2, ESP8266]

Parts:
C6, C8: 10µF; 0805
C7: 1uF; 0603
C9: 10uF; C0805K
C12: 6.2 pF; CAPC1005X55N
C13: 10uF; 0805
C15: 56 nF; CAPC1005X55N
C16, C17, C18, C21, C22, C23, C26, C27: 10 uF; CAPC3225X270N
D1: MBR120; SOD-123
D4: B270-13-F; DIOM5336X250N
IC1: CP2104; QFN24_4MM_SMSC
IC3: ESP-07S; ESP07S
IC4: LM5166DRCR; TPS74901DRCR
J1: 10104111-0001LF; 101041110001LF
J5: ZX20-B-5S-UNIT_30_; ZX20B5SUNIT30
L1: CLF6045T-151M-D; CLF6045T151MD
LED4: WS2812B5050; WS2812B
Q1, Q2: mmbt2222; SOT23-3
Q4: BSS138; SOT23-3
R1, R3, R4, R5, R7, R9, R16, R17: 10K; 0603
R2: 124K; RESC1005X40N
R6: 4.7K; 0603
R8: 383K; RESC1005X40N
R10: 100K; RESC1005X40N
R11: 1K; 0603
R12: 102K; RESC1005X40N
R26: 470 OHM; _0805MP
S2, S5: KSS221GLFS; KSS
U2: SPX3819; SOT23-5

Connections:
3.3V: C7.1, C8.1, C13.1, IC1.5 (VIO), IC1.6 (VDD), IC1.7 (REGIN), IC3.8 (VCC), Q4.1 (G), R1.2, R3.2, R9.2, R16.1, U2.5 (OUT); also elsewhere on the board
5V_BUCK: C12.2, C22.2 (C2), C23.2 (C2), C26.2 (C2), C27.2 (C2), D1.A, L1.2, R8.2
ADC: IC3.2 (ADC)
B_PLUS: C16.2 (C2), C17.2 (C2), C18.2 (C2), C21.2 (C2), D4.1 (K), IC4.EN, IC4.VIN
B_PLUS_CON: D4.2 (A), J5.1
CANH: J5.3; also elsewhere on the board
CANL: J5.5; also elsewhere on the board
CAN_CS: IC3.11 (GPIO2), R9.1; also elsewhere on the board
CAN_INT: IC3.13 (GPIO4); also elsewhere on the board
CH_PD: IC3.3 (EN), R1.1
DTR: IC1.23 (DTR), Q2.2 (E), R4.1
EN: R7.1, U2.3 (EN)
GND: C6.2, C7.2, C8.2, C9.2, C13.2, IC1.2 (GND), IC1.THERM (TP), IC3.9 (GND), J1.6 (M4), J1.7 (M1), J1.8 (M3), J1.9 (M2), J1.GND, J5.4, LED4.3-GND (GND), R6.1, S2.2, S5.2, U2.2 (GND); also elsewhere on the board
GND_BUCK: C15.1, C16.1 (C1), C17.1 (C1), C18.1 (C1), C21.1 (C1), C22.1 (C1), C23.1 (C1), C26.1 (C1), C27.1 (C1), IC4.EP1, IC4.GND, IC4.HYS, J5.2, R2.1, R10.1, R12.1
MISO: IC3.6 (GPIO12); also elsewhere on the board
MOSI: IC3.7 (GPIO13); also elsewhere on the board
unnamed: IC4.SW, L1.1
unnamed: IC4.ILIM, R10.2
unnamed: C12.1, IC4.FB, R2.2, R8.1
unnamed: IC1.3 (D+), J1.D+
unnamed: IC1.4 (D-), J1.D-
unnamed: Q1.1 (B), R4.2
unnamed: Q2.1 (B), R5.2
unnamed: C15.2, IC4.SS
unnamed: IC4.RT, R12.2
unnamed: LED4.4-DIN (DI), R26.2
PORTAL_PIN: IC3.14 (GPIO5), S2.1
RESET: IC3.1 (RST), IC3.4 (GPIO16), Q1.3 (C), R3.1, S5.1; also elsewhere on the board
RTS: IC1.19 (RTS), Q1.2 (E), R5.1
RXD: IC3.15 (RXD0), R11.2
SCK: IC3.5 (GPIO14); also elsewhere on the board
TFT_CS: IC3.12 (GPIO0), Q2.3 (C); also elsewhere on the board
TFT_DC: IC3.10 (GPIO15), R6.2; also elsewhere on the board
TXD: IC1.20 (RXD), IC3.16 (TXD0), Q4.2 (S), R16.2
TXD_5V: Q4.3 (D), R17.2, R26.1
USB_RX: IC1.21 (TXD), R11.1
VCC: C6.1, C9.1, D1.C, IC1.8 (VBUS), J1.VBUS, LED4.1-VDD (VDD), R7.2, R17.1, U2.1 (IN)

Notes on the sheet:
POWER AND FILTERING
RESET
USB TO SERIAL CONVERTER
ESP8266 MODULE + AUTORESET

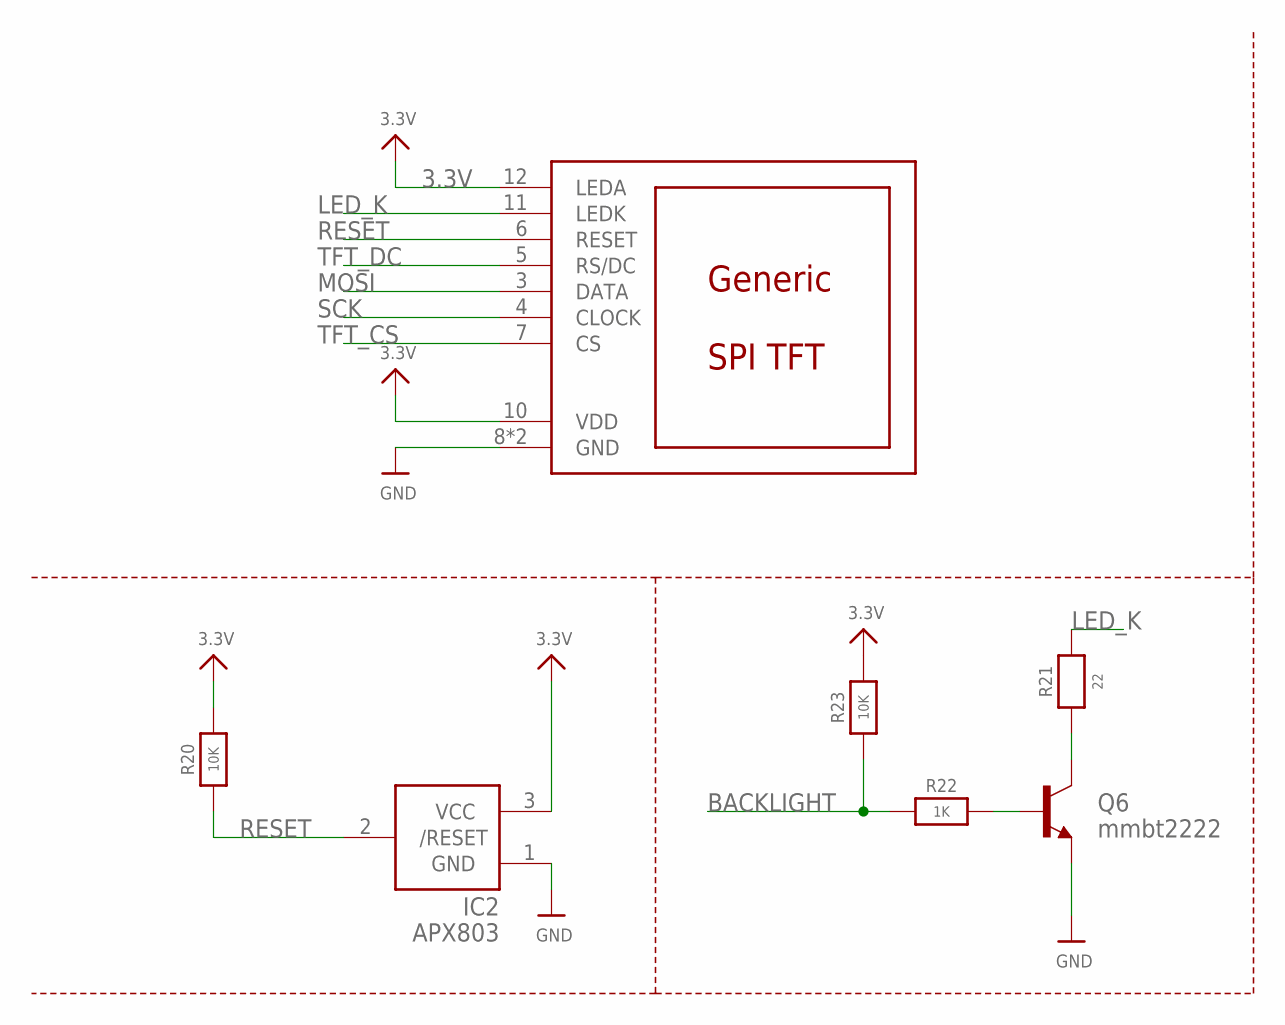
[picture p23: schematic pCloud_ESP9266.sch, sheet 3, TFT Display 240x135 ST7789]

Parts:
DISP1: DISP_LCD_GENERIC_SPI_1.14IN_240X135_WRAPUNDER; TFT_1.14IN_240X135_WRAPUNDER
IC2: APX803; SOT23
Q6: mmbt2222; SOT23-3
R20, R23: 10K; 0603
R21: 22; 0603
R22: 1K; 0603

Connections:
3.3V: DISP1.10 (VDD), DISP1.12 (LEDA), IC2.3 (VCC), R20.2, R23.2; also elsewhere on the board
BACKLIGHT: R22.1, R23.1
GND: DISP1.8 (GND), DISP1.13 (GND), IC2.1 (GND), Q6.2 (E); also elsewhere on the board
LED_K: DISP1.11 (LEDK), R21.2
MOSI: DISP1.3 (DATA); also elsewhere on the board
unnamed: Q6.1 (B), R22.2
unnamed: Q6.3 (C), R21.1
RESET: DISP1.6 (RESET), IC2.2 (/RESET), R20.1; also elsewhere on the board
SCK: DISP1.4 (CLOCK); also elsewhere on the board
TFT_CS: DISP1.7 (CS); also elsewhere on the board
TFT_DC: DISP1.5 (RS/DC); also elsewhere on the board

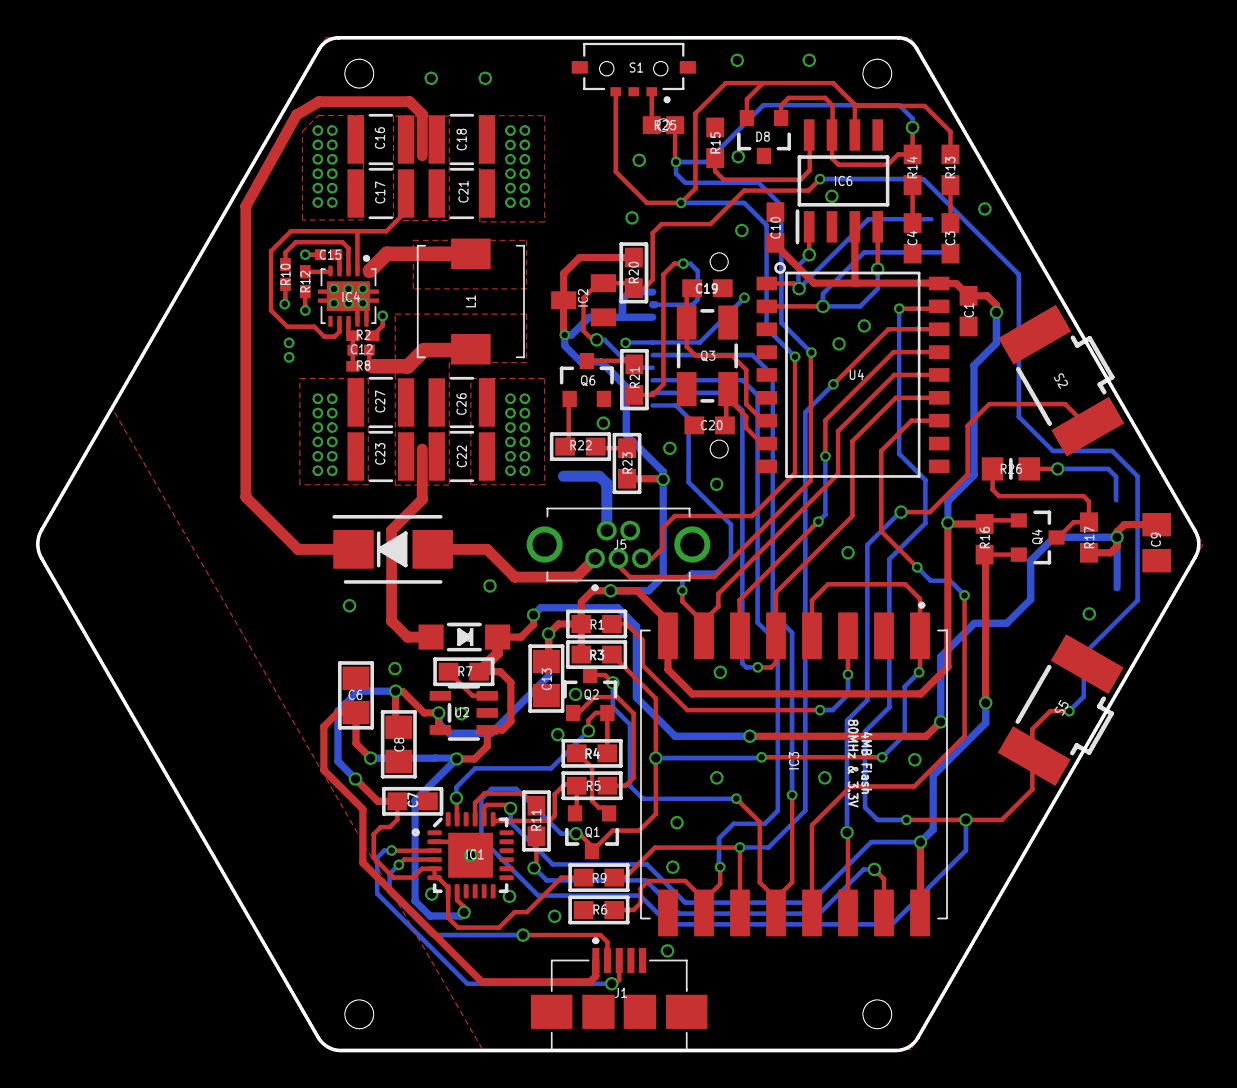
[picture p24: board pCloud_ESP9266.brd from above]

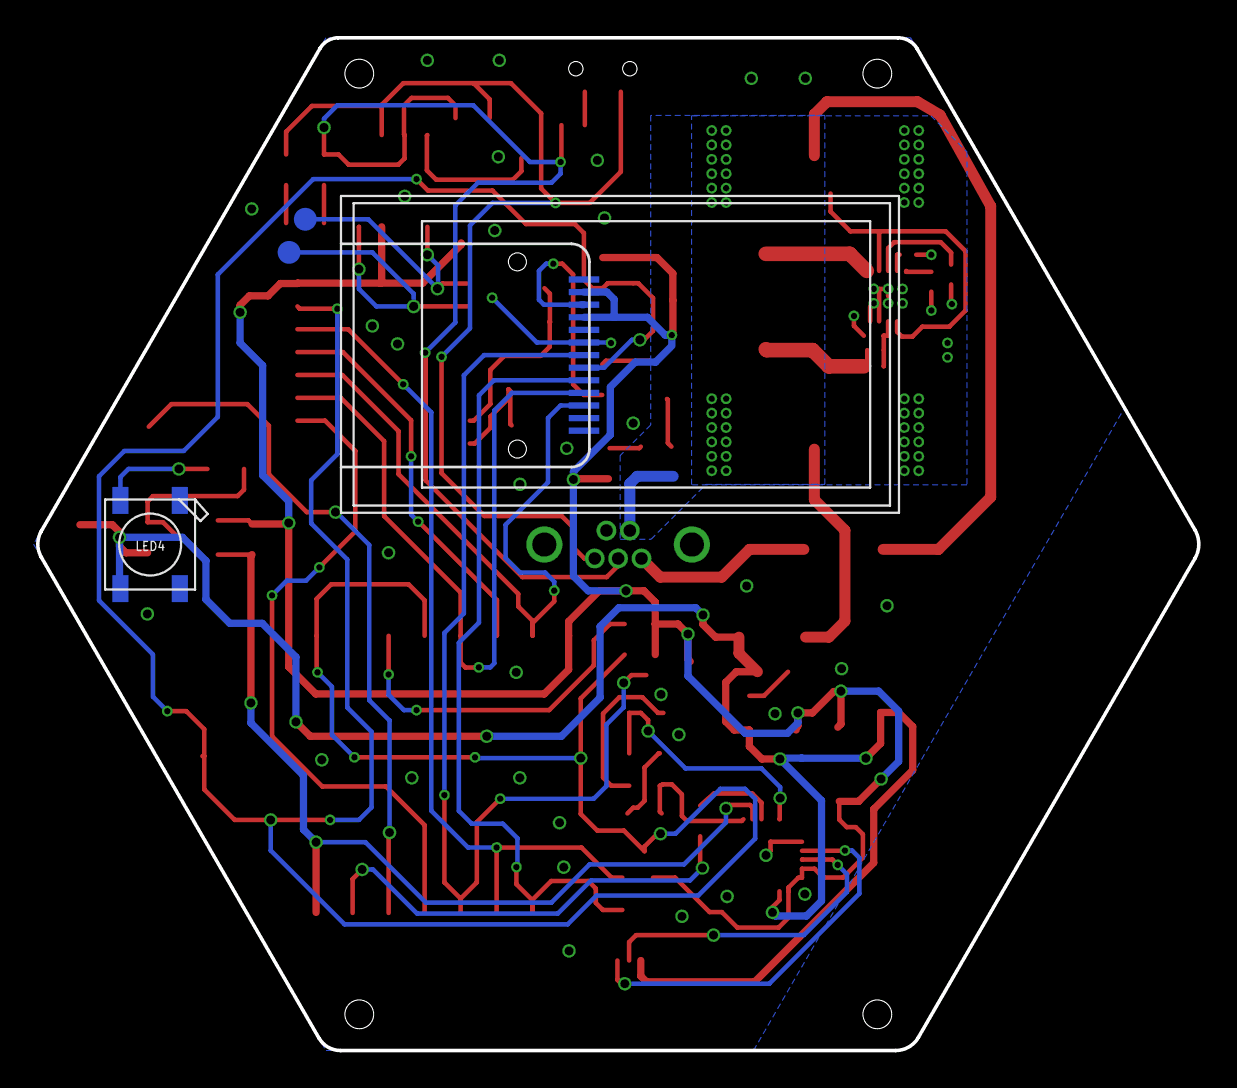
[picture p25: board pCloud_ESP9266.brd from below]

Board: 2 copper layers, 64.5 x 56.3 mm, 69 parts (4 on the bottom side), 48 nets.
