adrian-dumitrescu/IoT-CAN-Battery-Monitoring/pCloud_Firmware/TFT_Functions.ino

//*******************Display functions************************//
int getRSSIasQuality(int RSSI) {
  int quality = 0;

  if (RSSI <= -100) {
    quality = 0;
  } else if (RSSI >= -50) {
    quality = 100;
  } else {
    quality = 2 * (RSSI + 100);
  }
  return quality;
}
const unsigned char pCloud_Logo_Bitmap [] PROGMEM = {
  // 'pCloud_TFT, 104x60px
  0x00, 0x00, 0x00, 0x00, 0x00, 0x00, 0x00, 0x00, 0x00, 0x00, 0x00, 0x00, 0x00, 0x00, 0x00, 0x00,
  0x00, 0x00, 0x00, 0x00, 0x00, 0x00, 0x00, 0x00, 0x00, 0x00, 0x00, 0x00, 0xc0, 0x00, 0x00, 0x00,
  0x00, 0x00, 0x00, 0x00, 0x00, 0x00, 0x00, 0x00, 0x03, 0xf0, 0x00, 0x00, 0x00, 0x7f, 0xf8, 0x00,
  0x00, 0x00, 0x00, 0x00, 0x00, 0x0f, 0xf8, 0x00, 0x00, 0x03, 0xff, 0xff, 0x00, 0x00, 0x00, 0x00,
  0x00, 0x00, 0x1f, 0xfe, 0x00, 0x00, 0x1f, 0xff, 0xff, 0xc0, 0x00, 0x00, 0x00, 0x00, 0x00, 0x3f,
  0xfe, 0x00, 0x00, 0x3f, 0xff, 0xff, 0xf0, 0x00, 0x00, 0x00, 0x00, 0x00, 0x3f, 0xfe, 0x00, 0x00,
  0xff, 0xff, 0xff, 0xfc, 0x00, 0x00, 0x00, 0x00, 0x1e, 0x3f, 0xfe, 0x00, 0x01, 0xff, 0xff, 0xff,
  0xfe, 0x00, 0x00, 0x00, 0x00, 0x3f, 0x3f, 0xfe, 0x00, 0x07, 0xff, 0xff, 0xff, 0xff, 0x00, 0x00,
  0x00, 0x00, 0x3f, 0x3f, 0xfe, 0x00, 0x0f, 0xff, 0xff, 0xff, 0xff, 0x80, 0x00, 0x00, 0x00, 0x3f,
  0x3f, 0xfe, 0x00, 0x1f, 0xff, 0xff, 0xff, 0xff, 0xc0, 0x00, 0x00, 0x00, 0x3f, 0x3f, 0xfe, 0x00,
  0x3f, 0xff, 0xff, 0xff, 0xff, 0xe0, 0x00, 0x00, 0x00, 0x1e, 0x1f, 0xfe, 0x00, 0x3f, 0xff, 0xff,
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
};

// =========================================================================

void BMP_New_Update_Cloud() {
  //tft.fillRect(120, 0, 28, 23, 0x0000); // trebuie pus inainte
  tft.drawBitmap(82, 38, New_Update_Cloud_Bitmap, 53, 35, 0x05DD);

};

void BMP_New_Update_Arrow() {
  //tft.fillRect(120, 0, 28, 23, 0x0000); // trebuie pus inainte
  tft.drawBitmap(98, 60, New_Update_Arrow_Bitmap , 21, 23, 0x2F40);

};

// =========================================================================
void BMP_pCloud_Logo() {
  //tft.fillRect(1, 0, 104, 60, 0x0000); // trebuie pus inainte de Apelarea fct CAN_BUS_Bitmap 104x60px
  tft.drawBitmap(60, 25, pCloud_Logo_Bitmap, 104, 60, 0x05DD);
};

// =========================================================================
void BMP_CAN() {
  //tft.fillRect(50, 0, 64, 22, 0x0000); // trebuie pus inainte
  tft.drawBitmap(80, 15, CAN_Bitmap, 29, 22, 0x05DD); //blue
};

void BMP_CAN_OFF() {
  //tft.fillRect(50, 0, 64, 22, 0x0000); // trebuie pus inainte
  tft.drawBitmap(110, 15, CAN_OFF_Bitmap, 32, 22, 0xE820); //red
};

void BMP_CAN_ON() {
  //tft.fillRect(50, 0, 60, 22, 0x0000); // trebuie pus inainte
  tft.drawBitmap(110, 15, CAN_ON_Bitmap, 28, 22, 0x2F40); //green
};

// =========================================================================
void BMP_S_New_Update_Cloud() {
  //tft.fillRect(120, 0, 28, 23, 0x0000); // trebuie pus inainte
  tft.drawBitmap(200, 15, S_New_Update_Cloud_Bitmap, 31, 21, 0x05DD);
};

void BMP_S_New_Update_Arrow() {
  //tft.fillRect(120, 0, 28, 23, 0x0000); // trebuie pus inainte
  tft.drawBitmap(209, 26, S_New_Update_Arrow_Bitmap, 12, 13, 0x2F40);
};

// =========================================================================
void BMP_BatterySmall() {

  //TFT_SOC = random(100);
  tft.fillRect(98, 0, 82, 15, 0x0000);
  if (TFT_SOC < 10) {
    // tft.fillScreen(0x0000);
    tft.drawBitmap(98, 0, Battery_NA_Bitmap, 35, 15, CULOARE[0]);
    battText(CULOARE[0]);
  }
  if ((TFT_SOC >= 10) && (TFT_SOC < 25)) {
    //  tft.fillScreen(0x0000);
    tft.drawBitmap(98, 0, Battery_25_Bitmap, 35, 15, CULOARE[0]);
    battText(CULOARE[0]);
  }
  if ((TFT_SOC >= 25) && (TFT_SOC < 50)) {
    // tft.fillScreen(0x0000);
    tft.drawBitmap(98, 0, Battery_50_Bitmap, 35, 15, CULOARE[0]);
    battText(CULOARE[0]);
  }
  if ((TFT_SOC >= 50) && (TFT_SOC < 75)) {
    // tft.fillScreen(0x0000);
    tft.drawBitmap(98, 0, Battery_75_Bitmap, 35, 15, CULOARE[0]);
    battText(CULOARE[0]);
  }
  if (TFT_SOC >= 75) {
    // tft.fillScreen(0x0000);
    tft.drawBitmap(98, 0, Battery_100_Bitmap, 35, 15, CULOARE[0]);
    battText(CULOARE[0]);
  }
  //delay(1000);
  // tft.fillScreen(0x0000);
};
void BMP_BatteryBig_Setup() {
  tft.fillRect(70, 60, 150, 39, 0x0000);
  tft.drawBitmap(70, 60, Battery_NA_Bitmap2, 99, 39, 0x05DD);
  battText2(0x05DD);
  battText3(0x05DD);
}
void BMP_BatteryBig() {


  //  tft.fillRect(9, 20, 140, 41, 0x0000);
  //  tft.fillScreen(0x0000);

  //tft.drawBitmap(9, 28, Battery_NA_Bitmap2, 104, 45, CULOARE[0]); // am adaugat 10 la X din (Y,X,L,H)
  //tft.fillRect(16, 35, 79, 30, 0x0000); // (Y,X,L,H)
  
  tft.fillRect(70, 60, 99, 39, 0x0000);
  tft.drawBitmap(70, 60, Battery_NA_Bitmap2, 99, 39, 0x05DD);
  
  if (ROUND_TFT_SOC < 10) {
    // tft.fillScreen(0x0000);
    tft.drawBitmap(70, 60, Battery_NA_Bitmap2, 99, 39, 0xE820);
    battText2(0xE820);
    battText3(0xE820);  
  }
  if ((ROUND_TFT_SOC >= 10) && (ROUND_TFT_SOC <= 25)) {
    //  tft.fillScreen(0x0000);
    //tft.drawBitmap(9, 28, Battery_NA_Bitmap2, 104, 45, 0xEA80);
    tft.drawBitmap(75, 65, Battery_25_Bitmap2, 79, 29, 0xEA80);
    battText2(0xEA80);
    battText3(0xEA80);  
  }
  if ((ROUND_TFT_SOC > 25) && (ROUND_TFT_SOC <= 50)) {
    // tft.fillScreen(0x0000);
    //tft.drawBitmap(9, 28, Battery_NA_Bitmap2, 104, 45, 0xEEA0);
    tft.drawBitmap(75, 65, Battery_50_Bitmap2, 79, 29, 0xEEA0);
    battText2(0xEEA0);
    battText3(0xEEA0);
  }
  if ((ROUND_TFT_SOC > 50) && (ROUND_TFT_SOC <= 75)) {
    // tft.fillScreen(0x0000);
    //tft.drawBitmap(9, 28, Battery_NA_Bitmap2, 104, 45, 0x7740);
    tft.drawBitmap(75, 65, Battery_75_Bitmap2, 79, 29, 0x7740);
    battText2(0x7740);
    battText3(0x7740);
  }
  if (ROUND_TFT_SOC > 75) {
    // tft.fillScreen(0x0000);
    //tft.drawBitmap(9, 28, Battery_NA_Bitmap2, 104, 45, 0x2F40);
    tft.drawBitmap(75, 65, Battery_100_Bitmap2, 79, 29, 0x2F40);
    battText2(0x2F40);
    battText3(0x2F40);
  }
  // delay(50);
  // tft.fillScreen(0x0000);
  //    tft.fillRect(16, 25, 77, 30, ST7735_RED);  // (Y,X,L,H) -------FOR TEST
  
};

void BMP_WiFi() {

  tft.fillRect(5, 15, 27, 15, 0x0000);

  if (TFT_WiFi_Strength < 10) {
    // tft.fillScreen(0x0000);
    tft.drawBitmap(5, 15, WiFi_NA_Bitmap, 27, 15, 0xE820);

  }
  else if ((TFT_WiFi_Strength >= 10) && (TFT_WiFi_Strength < 25)) {
    // tft.fillScreen(0x0000);
    tft.drawBitmap(5, 15, WiFi_25_Bitmap, 27, 15, 0xEA80);

  }
  else if ((TFT_WiFi_Strength >= 25) && (TFT_WiFi_Strength < 50)) {
    // tft.fillScreen(0x0000);
    tft.drawBitmap(5, 15, WiFi_50_Bitmap, 27, 15, 0xEEA0);

  }
  else if ((TFT_WiFi_Strength >= 50) && (TFT_WiFi_Strength < 75)) {
    // tft.fillScreen(0x0000);
    tft.drawBitmap(5, 15, WiFi_75_Bitmap, 27, 15, 0x7740);

  }
  else if (TFT_WiFi_Strength >= 75) {
    //  tft.fillScreen(0x0000);
    tft.drawBitmap(5, 15, WiFi_100_Bitmap, 27, 15, 0x2F40);

  }
};

void BMP_NoWiFi() {
  tft.fillRect(5, 15, 27, 15, 0x0000);
  tft.drawBitmap(5, 15, WiFi_NA_Bitmap, 27, 15, 0xE820);
};

void drawText1(char *text, uint16_t color) {
  //tft.setFont(&FreeMono9pt7b);
  //tft.setFont(&FreeSans9pt7b); 
  //tft.fillRect(5, 25, 165, 10, 0x0000);
  tft.fillRect(30, 45, 160, 10, 0x0000);
  tft.setCursor(40, 45);
  tft.setTextColor(color);
  tft.setTextSize(1);
  tft.setTextWrap(true);
  tft.print(text);
}

void drawText2(char *text, uint16_t color) {
  //tft.setFont(&FreeMono9pt7b);
  tft.fillRect(30, 65, 160, 10, 0x0000);
  tft.setCursor(40, 65);
  tft.setTextColor(color);
  tft.setTextSize(1);
  tft.setTextWrap(true);
  tft.print(text);
}

void drawText3(char *text, uint16_t color) {
  //tft.setFont(&FreeMono12pt7b);
  tft.setCursor(40, 45);
  tft.setTextColor(color);
  tft.setTextSize(2);
  tft.setTextWrap(true);
  tft.print(text);
}

void drawText4(char *text, uint16_t color) {
  //tft.setFont(&FreeMono12pt7b);
  tft.setCursor(40, 65);
  tft.setTextColor(color);
  tft.setTextSize(2);
  tft.setTextWrap(true);
  tft.print(text);
}

void drawText5(char *text, uint16_t color) {
  //tft.setFont(&FreeMono12pt7b);
  tft.setCursor(40, 90);
  tft.setTextColor(color);
  tft.setTextSize(2);
  tft.setTextWrap(true);
  tft.print(text);
}

/*
void BMP_LoadingBar() {

  unsigned long currentTime = millis();
  // tft.drawCircle(Y, X, r, culoare);
  tft.fillCircle(65, 100, 3, CULOARE[(loading_cycle + 5) % 6]);
  tft.fillCircle(75, 100, 3, CULOARE[(loading_cycle + 4) % 6]);
  tft.fillCircle(85, 100, 3, CULOARE[(loading_cycle + 3) % 6]);
  tft.fillCircle(95, 100, 3, CULOARE[(loading_cycle + 2) % 6]);
  tft.fillCircle(105, 100, 3, CULOARE[(loading_cycle + 1) % 6]);
  tft.fillCircle(55, 100, 3, CULOARE[loading_cycle % 6]);
  loading_cycle = loading_cycle + 1;
  if (loading_cycle == 7) {
    loading_cycle = loading_cycle;
  }
}
*/

void BMP_LoadingBar() {

  unsigned long currentTime = millis();
  // tft.drawCircle(Y, X, r, culoare);
  tft.fillCircle(90, 110, 4, CULOARE[(loading_cycle + 5) % 6]);
  tft.fillCircle(110, 110, 4, CULOARE[(loading_cycle + 4) % 6]);
  tft.fillCircle(130, 110, 4, CULOARE[(loading_cycle + 3) % 6]);
  tft.fillCircle(150, 110, 4, CULOARE[(loading_cycle + 2) % 6]);
  tft.fillCircle(170, 110, 4, CULOARE[(loading_cycle + 1) % 6]);
  tft.fillCircle(70, 110, 4, CULOARE[loading_cycle % 6]);
  loading_cycle = loading_cycle + 1;
  if (loading_cycle == 7) {
    loading_cycle = loading_cycle;
  }
}

void battText( uint16_t color) {
  // tft.fillRect(135, 4, 35, 15, 0x0000);
  tft.setCursor(135, 4);
  tft.setTextColor(color);
  tft.setTextSize(1);
  //tft.setTextWrap(true);
  tft.print(ROUND_TFT_SOC);
  tft.print("%");
}

void battText2( uint16_t color) {
  tft.fillRect(180, 72, 48, 15, 0x0000);
  tft.setCursor(180, 72);
  tft.setTextColor(color);
  tft.setTextSize(2);
  //tft.setTextWrap(true);
  tft.print(ROUND_TFT_SOC);
  tft.print("%");
  //tft.fillRect(112, 34, 48, 15, ST7735_RED); // (Y,X,L,H) -------FOR TEST
}
void battText3( uint16_t color) {
  tft.fillRect(20, 72, 48, 15, 0x0000);
  tft.setCursor(20, 72);
  tft.setTextColor(color);
  tft.setTextSize(2);
  //tft.setTextWrap(true);
  tft.print("SoC:");

  //tft.fillRect(112, 34, 48, 15, ST7735_RED); // (Y,X,L,H) -------FOR TEST
}
